endurancerc/32_Servo_Controller/README.md

# 32_Servo_Controller
Firmware for the Endurance R/C 32 Servo Controller
