endurancerc/32_Servo_Controller/FIRMWARE/settings.jpg

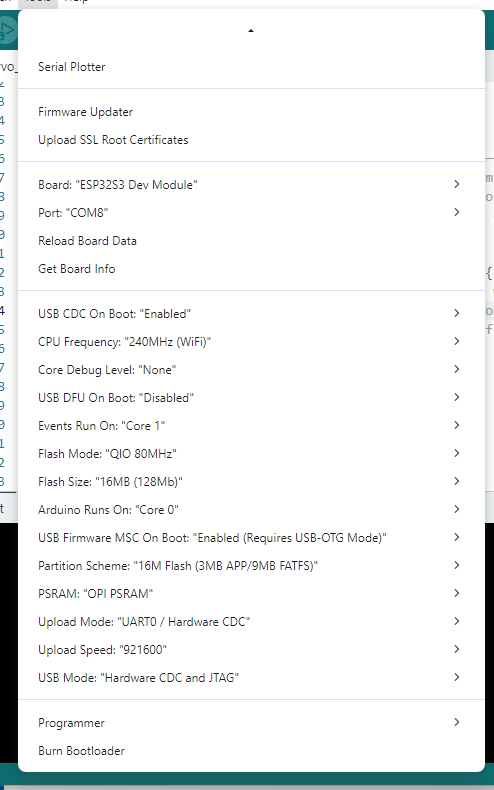
FIRMWARE/settings.jpg
