endurancerc/32_Servo_Controller/PCB/32_Servo_Controller_Schematic.pdf

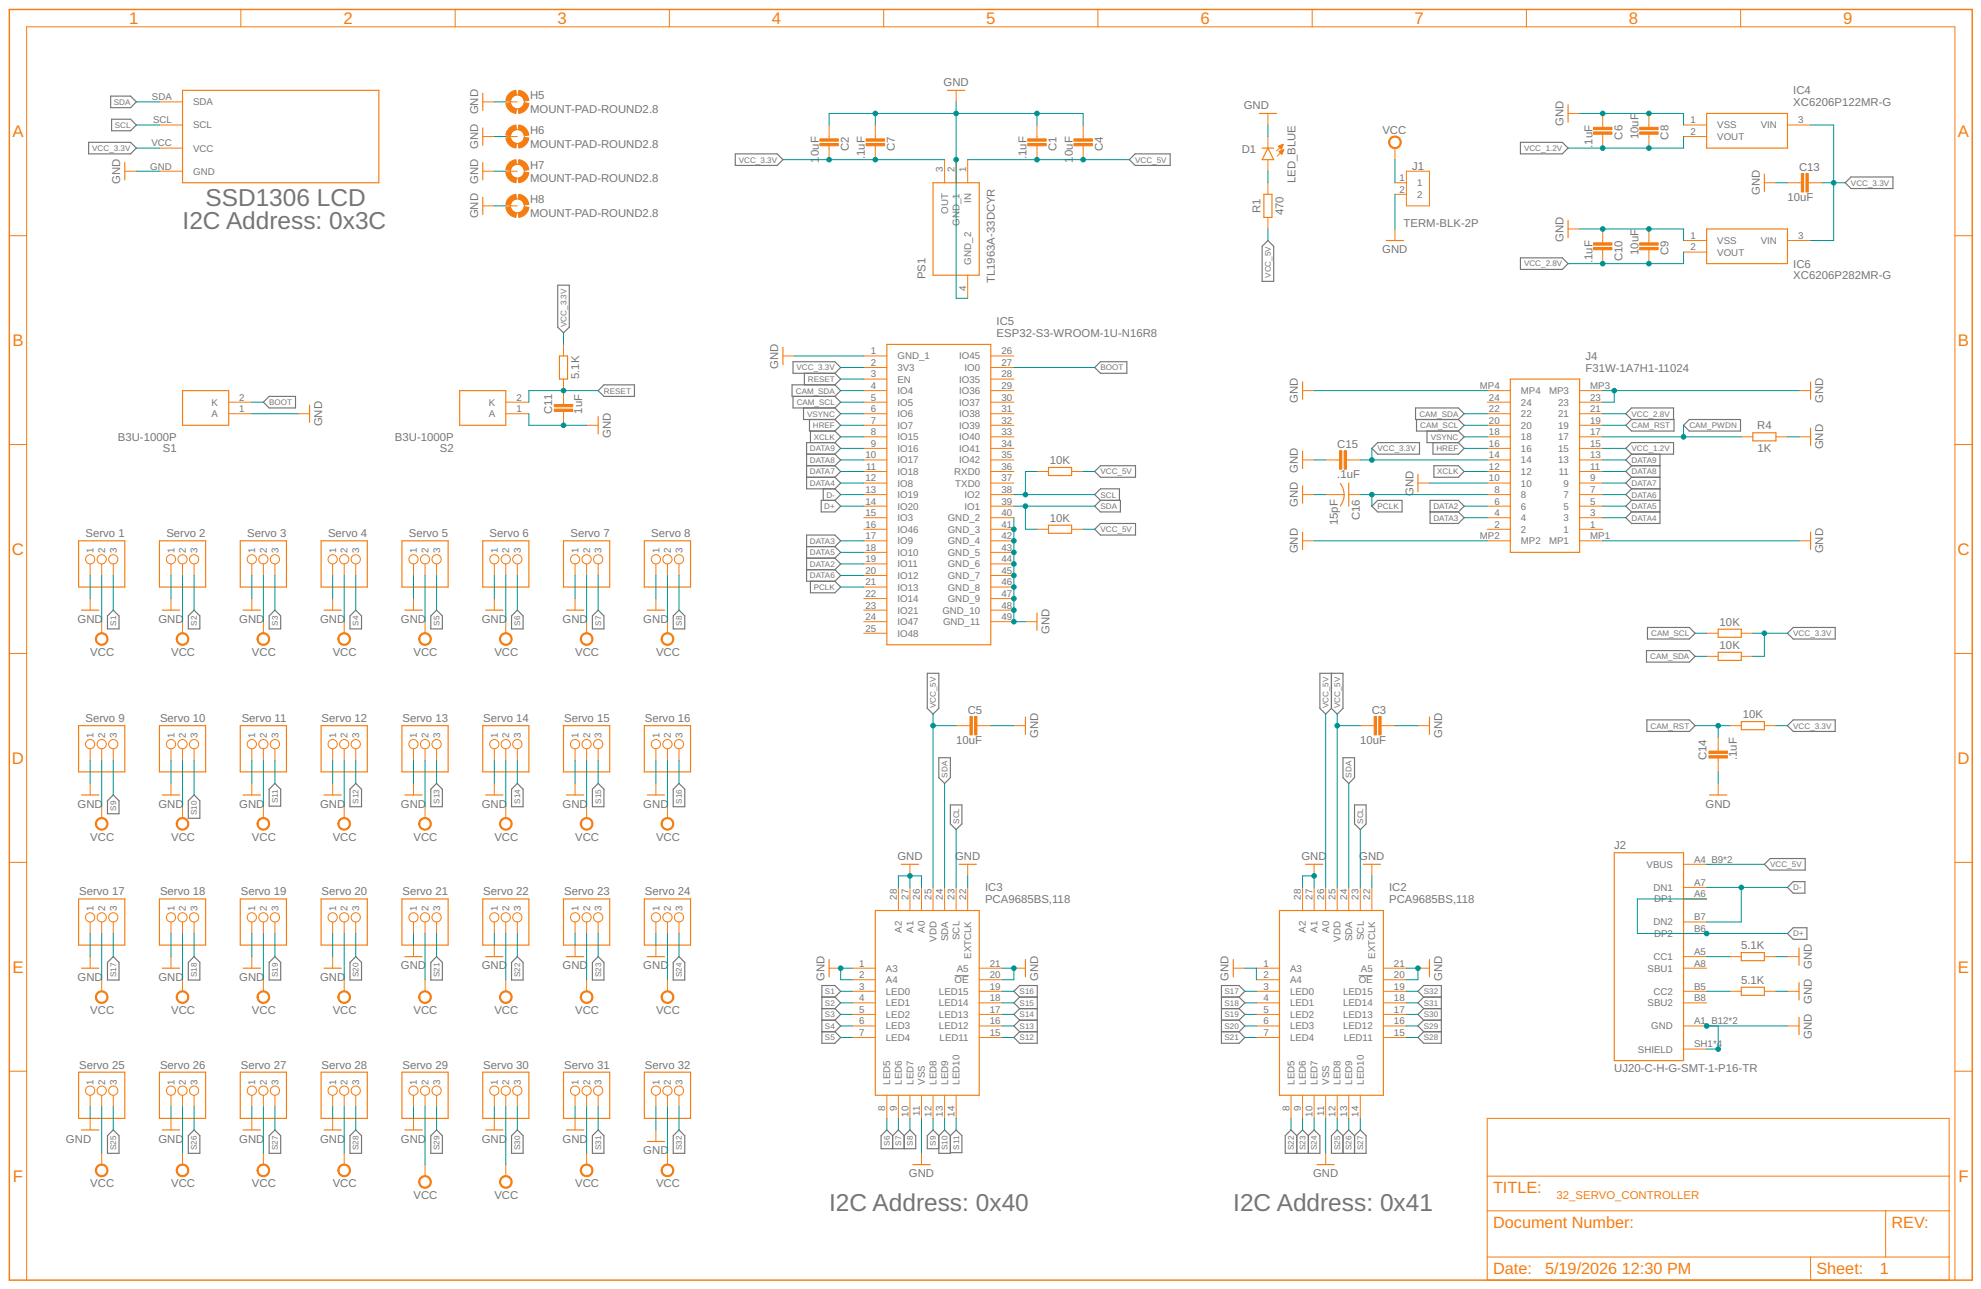
[picture p6: page 1]

GND GND

Document Number: | REV:

Date: 5/19/2026 12:30 PM | Sheet: 1
