endurancerc/32_Servo_Controller/PCB/esp32_servo_lcd_cam.brd

## EAGLE design PCB/esp32_servo_lcd_cam.brd (2026-05-15)

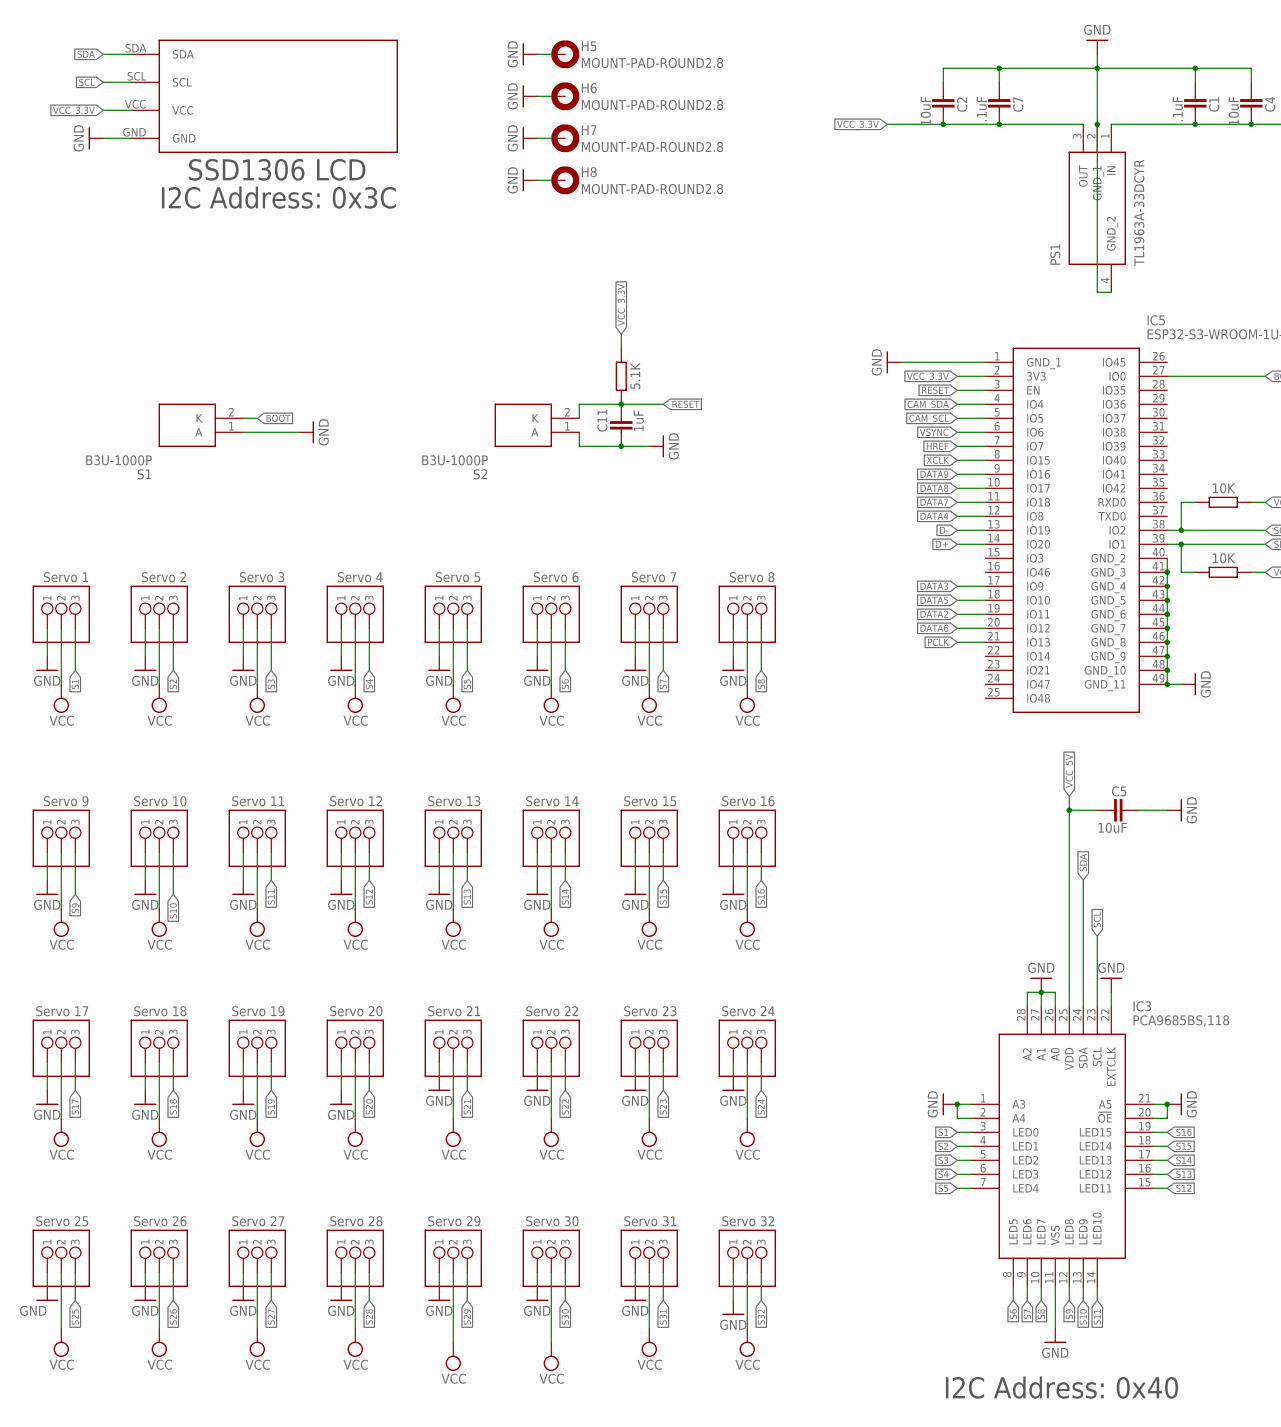
[picture p7: schematic esp32_servo_lcd_cam.sch, part in row 1, column 1]

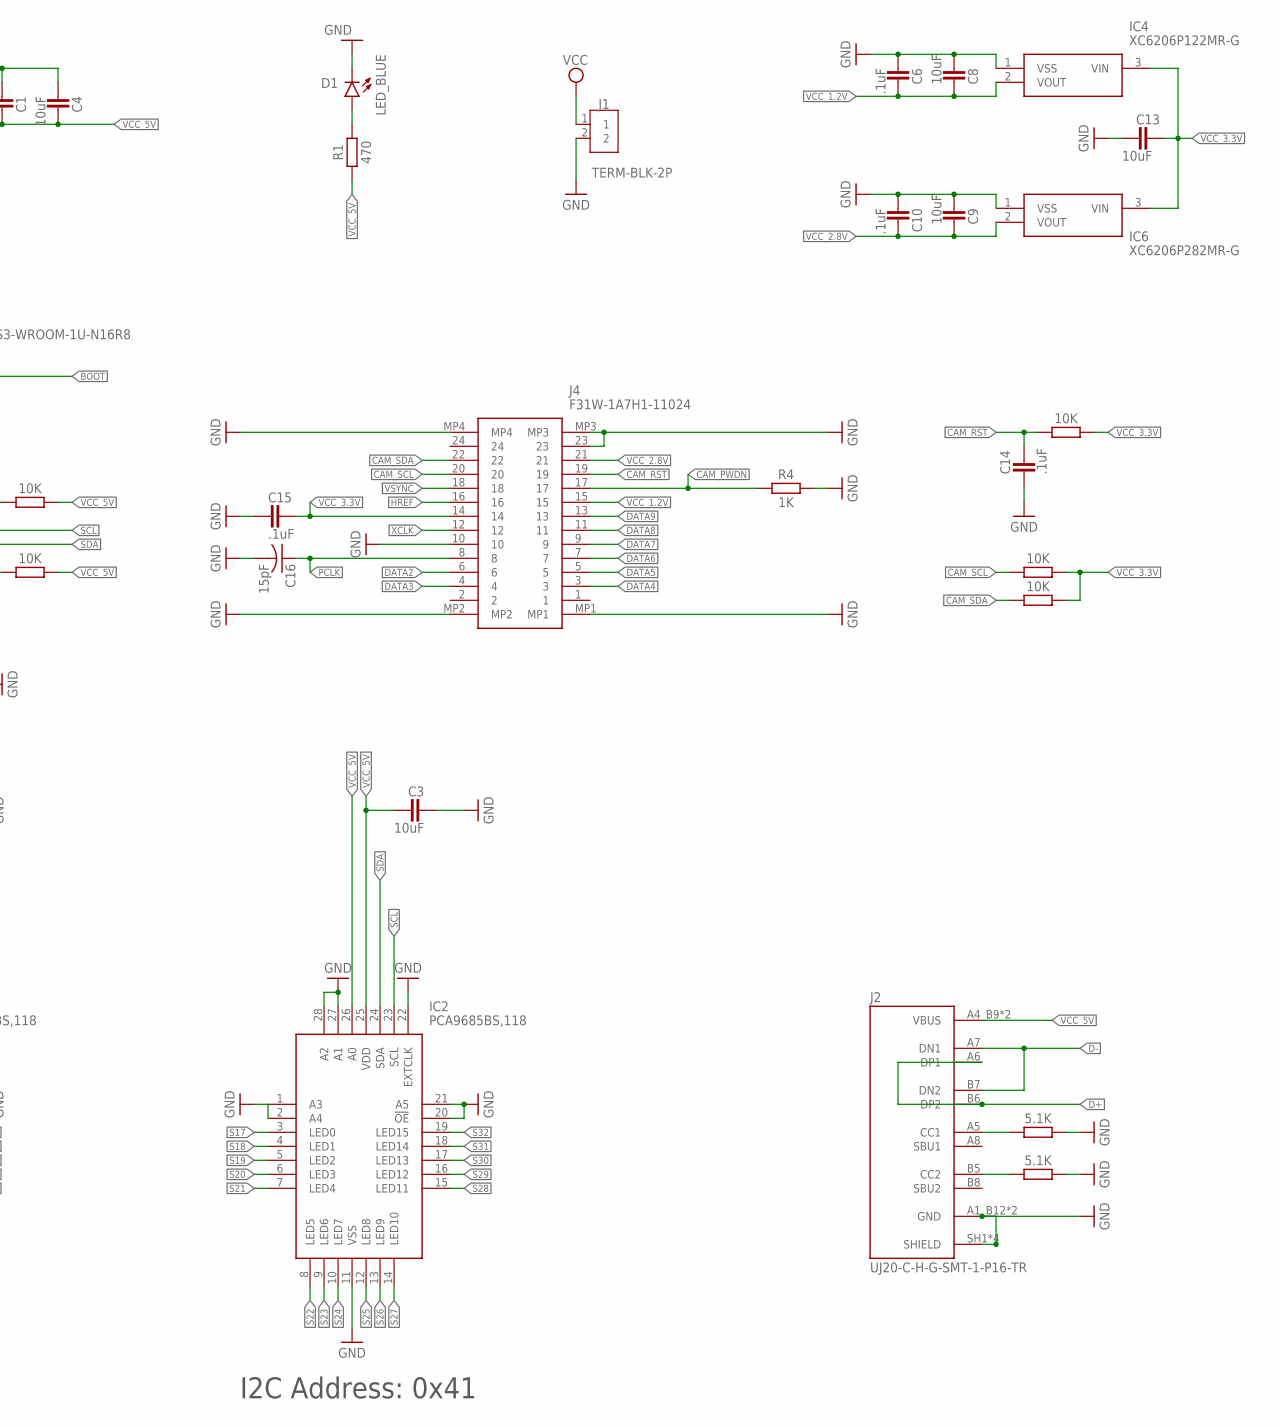
[picture p8: schematic esp32_servo_lcd_cam.sch, part in row 1, column 2]

Parts:
C1, C6, C7, C10, C14, C15: .1uF; CAPC1110X102
C2, C3, C4, C5, C8, C9, C13: 10uF; CAPC1110X102
C11: 1uF; CAPC1110X102
C16: 15pF; CAPC2012X110
D1: LED_BLUE; LEDC1608X80N_FLAT-B
H5, H6, H7, H8: MOUNT-PAD-ROUND2.8; 2,8-PAD
IC2, IC3: PCA9685BS,118; QFN65P600X600X100-29N
IC4: XC6206P122MR-G; SOT95P280X130-3N
IC5: ESP32-S3-WROOM-1U-N16R8; ESP32S3WROOM1UN16R8
IC6: XC6206P282MR-G; SOT95P280X130-3N
J1: TERM-BLK-2P; TERMBLK_508-2N
J2: UJ20-C-H-G-SMT-1-P16-TR; SAMESKY_UJ20-C-H-G-SMT-1-P16-TR
J4: F31W-1A7H1-11024; F31W1A7H111024
PS1: TL1963A-33DCYR; SOT230P700X180-4N
R1: 470; RESC1005X40
R2, R11, R12: 5.1K; RESC1005X40
R3, R5, R6, R23, R24: 10K; RESC1005X40
R4: 1K; RESC1608X60
S1, S2: B3U-1000P
U$1: Servo 6; 1X03
U$2: Servo 7; 1X03
U$3: Servo 8; 1X03
U$4: Servo 9; 1X03
U$5: Servo 10; 1X03
U$6: Servo 11; 1X03
U$7: Servo 12; 1X03
U$8: Servo 13; 1X03
U$9: Servo 14; 1X03
U$10: Servo 15; 1X03
U$11: Servo 4; 1X03
U$12: Servo 5; 1X03
U$13: Servo 1; 1X03
U$14: Servo 3; 1X03
U$15: Servo 2; 1X03
U$16: Servo 16; 1X03
U$17: Servo 17; 1X03
U$18: Servo 18; 1X03
U$19: Servo 19; 1X03
U$20: Servo 21; 1X03
U$21: Servo 20; 1X03
U$22: Servo 22; 1X03
U$23: Servo 23; 1X03
U$24: Servo 24; 1X03
U$25: Servo 25; 1X03
U$26: Servo 26; 1X03
U$27: Servo 27; 1X03
U$28: Servo 28; 1X03
U$29: Servo 29; 1X03
U$30: Servo 30; 1X03
U$31: Servo 31; 1X03
U$32: Servo 32; 1X03
U$33: 128X32_SSD1306_I2C_LCD; 128X32_SSD1306_I2C_LCD_

Connections:
BOOT: IC5.27 (IO0), S1.2 (K)
CAM_PWDN: J4.17, R4.1
CAM_RST: C14.1, J4.19, R3.1
CAM_SCL: IC5.5 (IO5), J4.20, R5.1
CAM_SDA: IC5.4 (IO4), J4.22, R6.1
D+: IC5.14 (IO20), J2.A6 (DP1), J2.B6 (DP2)
D-: IC5.13 (IO19), J2.A7 (DN1), J2.B7 (DN2)
DATA2: IC5.19 (IO11), J4.6
DATA3: IC5.17 (IO9), J4.4
DATA4: IC5.12 (IO8), J4.3
DATA5: IC5.18 (IO10), J4.5
DATA6: IC5.20 (IO12), J4.7
DATA7: IC5.11 (IO18), J4.9
DATA8: IC5.10 (IO17), J4.11
DATA9: IC5.9 (IO16), J4.13
GND: C1.2, C2.2, C3.1, C4.2, C5.1, C6.2, C7.2, C8.2, C9.2, C10.2, C11.2, C13.2, C14.2, C15.2, C16.2, D1.C, H5.B2,8, H6.B2,8, H7.B2,8, H8.B2,8, IC2.11 (VSS), IC2.20 (!OE), IC2.21 (A5), IC2.27 (A1), IC2.28 (A2), IC3.1 (A3), IC3.2 (A4), IC3.11 (VSS), IC3.20 (!OE), IC3.21 (A5), IC3.22 (EXTCLK), IC3.26 (A0), IC3.27 (A1), IC3.28 (A2), IC4.1 (VSS), IC5.1 (GND_1), IC5.40 (GND_2), IC5.41 (GND_3), IC5.42 (GND_4), IC5.43 (GND_5), IC5.44 (GND_6), IC5.45 (GND_7), IC5.46 (GND_8), IC5.47 (GND_9), IC5.48 (GND_10), IC5.49 (GND_11), IC6.1 (VSS), J1.2, J2.A1_B12 (GND), J2.B1_A12 (GND), J2.SH1 (SHIELD), J2.SH2 (SHIELD), J2.SH3 (SHIELD), J2.SH4 (SHIELD), J4.10, J4.23, J4.MP1, J4.MP2, J4.MP3, J4.MP4, PS1.2 (GND_1), PS1.4 (GND_2), R4.2, R11.2, R12.2, S1.1 (A), S2.1 (A), U$1.1, U$2.1, U$3.1, U$4.1, U$5.1, U$6.1, U$7.1, U$8.1, U$9.1, U$10.1, U$11.1, U$12.1, U$13.1, U$14.1, U$15.1, U$16.1, U$17.1, U$18.1, U$19.1, U$20.1, U$21.1, U$22.1, U$23.1, U$24.1, U$25.1, U$26.1, U$27.1, U$28.1, U$29.1, U$30.1, U$31.1, U$32.1, U$33.GND
HREF: IC5.7 (IO7), J4.16
unnamed: D1.A, R1.2
unnamed: J2.A5 (CC1), R12.1
unnamed: J2.B5 (CC2), R11.1
PCLK: C16.1, IC5.21 (IO13), J4.8
RESET: C11.1, IC5.3 (EN), R2.2, S2.2 (K)
S1: IC3.3 (LED0), U$13.3
S2: IC3.4 (LED1), U$15.3
S3: IC3.5 (LED2), U$14.3
S4: IC3.6 (LED3), U$11.3
S5: IC3.7 (LED4), U$12.3
S6: IC3.8 (LED5), U$1.3
S7: IC3.9 (LED6), U$2.3
S8: IC3.10 (LED7), U$3.3
S9: IC3.12 (LED8), U$4.3
S10: IC3.13 (LED9), U$5.3
S11: IC3.14 (LED10), U$6.3
S12: IC3.15 (LED11), U$7.3
S13: IC3.16 (LED12), U$8.3
S14: IC3.17 (LED13), U$9.3
S15: IC3.18 (LED14), U$10.3
S16: IC3.19 (LED15), U$16.3
S17: IC2.3 (LED0), U$17.3
S18: IC2.4 (LED1), U$18.3
S19: IC2.5 (LED2), U$19.3
S20: IC2.6 (LED3), U$21.3
S21: IC2.7 (LED4), U$20.3
S22: IC2.8 (LED5), U$22.3
S23: IC2.9 (LED6), U$23.3
S24: IC2.10 (LED7), U$24.3
S25: IC2.12 (LED8), U$25.3
S26: IC2.13 (LED9), U$26.3
S27: IC2.14 (LED10), U$27.3
S28: IC2.15 (LED11), U$28.3
S29: IC2.16 (LED12), U$29.3
S30: IC2.17 (LED13), U$30.3
S31: IC2.18 (LED14), U$31.3
S32: IC2.19 (LED15), U$32.3
SCL: IC2.23 (SCL), IC3.23 (SCL), IC5.38 (IO2), R23.1, U$33.SCL
SDA: IC2.24 (SDA), IC3.24 (SDA), IC5.39 (IO1), R24.1, U$33.SDA
VCC: J1.1, U$1.2, U$2.2, U$3.2, U$4.2, U$5.2, U$6.2, U$7.2, U$8.2, U$9.2, U$10.2, U$11.2, U$12.2, U$13.2, U$14.2, U$15.2, U$16.2, U$17.2, U$18.2, U$19.2, U$20.2, U$21.2, U$22.2, U$23.2, U$24.2, U$25.2, U$26.2, U$27.2, U$28.2, U$29.2, U$30.2, U$31.2, U$32.2
VCC_1.2V: C6.1, C8.1, IC4.2 (VOUT), J4.15
VCC_2.8V: C9.1, C10.1, IC6.2 (VOUT), J4.21
VCC_3.3V: C2.1, C7.1, C13.1, C15.1, IC4.3 (VIN), IC5.2 (3V3), IC6.3 (VIN), J4.14, PS1.3 (OUT), R2.1, R3.2, R5.2, R6.2, U$33.VCC
VCC_5V: C1.1, C3.2, C4.1, C5.2, IC2.25 (VDD), IC2.26 (A0), IC3.25 (VDD), J2.A4_B9 (VBUS), J2.B4_A9 (VBUS), PS1.1 (IN), R1.1, R23.2, R24.2
VSYNC: IC5.6 (IO6), J4.18
XCLK: IC5.8 (IO15), J4.12

Notes on the sheet:
SSD1306 LCD
I2C Address: 0x40
I2C Address: 0x3C
I2C Address: 0x41

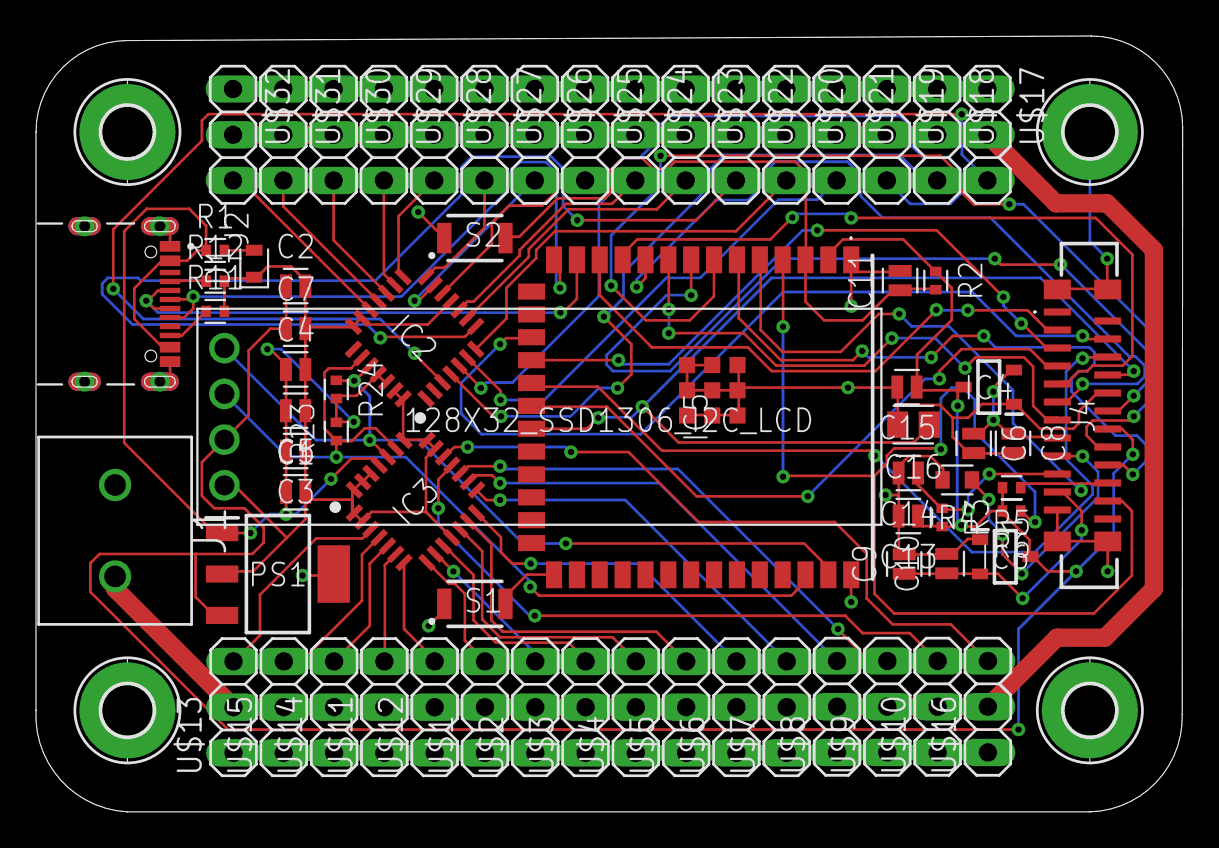
[picture p9: board esp32_servo_lcd_cam.brd from above]

Board: 2 copper layers, 63.7 x 43.1 mm, 74 parts (0 on the bottom side), 63 nets.
