endurancerc/32_Servo_Controller/FIRMWARE/32_Servo_Controller_Camera.ino

// ─────────────────────────────────────────────────────────────
//  32 Servo Controller — Combined USB HID + WiFi + Camera
//  Boots into USB HID mode if USB host detected, WiFi otherwise
//  WiFi mode: OV2640 MJPEG stream on port 81, servo control on port 80
//  Host fingerprinting detects Android vs Windows via HID timing delta
// ─────────────────────────────────────────────────────────────

// These defines burn the correct strings into the compiled USB descriptor,
// so Chrome's device picker shows the right name before setup() even runs.
#define USB_PRODUCT      "32 Servo Controller"
#define USB_MANUFACTURER "Endurance R/C"

#include "esp_camera.h"
#include <WiFi.h>
#include <WebServer.h>
#include <Preferences.h>
#include <DNSServer.h>
#include <ESPmDNS.h>
#include <Wire.h>
#include <Adafruit_PWMServoDriver.h>
#include <Adafruit_GFX.h>
#include <Adafruit_SSD1306.h>
#include "USB.h"
#include "USBHID.h"
#include "USBCDC.h"
#include "esp_system.h"        // esp_reset_reason()
#include "esp_task_wdt.h"      // esp_task_wdt_delete()
#include "soc/soc.h"           // WRITE_PERI_REG
#include "soc/rtc_cntl_reg.h"  // RTC_CNTL_BROWN_OUT_REG

USBCDC FPSerial;

// ─────────────────────────────────────────────────────────────
//  Common hardware defines
// ─────────────────────────────────────────────────────────────
#define I2C_SDA 1
#define I2C_SCL 2
#define NUM_SERVOS 32
#define SERVO_FREQ 50
#define USMIN 600
#define USMAX 2400
#define US_SCALE 7.06f

#define SCREEN_WIDTH 128
#define SCREEN_HEIGHT 32
#define OLED_RESET -1
#define SCREEN_ADDRESS 0x3C

// ─────────────────────────────────────────────────────────────
//  OV2640 Camera pin map
// ─────────────────────────────────────────────────────────────
#define PWDN_GPIO_NUM   -1   // not wired
#define RESET_GPIO_NUM  -1
#define XCLK_GPIO_NUM   15
#define SIOD_GPIO_NUM    4   // camera SCCB SDA (separate bus from servo I2C)
#define SIOC_GPIO_NUM    5   // camera SCCB SCL
#define Y2_GPIO_NUM     11
#define Y3_GPIO_NUM      9
#define Y4_GPIO_NUM      8
#define Y5_GPIO_NUM     10
#define Y6_GPIO_NUM     12
#define Y7_GPIO_NUM     18
#define Y8_GPIO_NUM     17
#define Y9_GPIO_NUM     16
#define VSYNC_GPIO_NUM   6
#define HREF_GPIO_NUM    7
#define PCLK_GPIO_NUM   13
// If camera init returns error 0x105, try: #define XCLK_GPIO_NUM 40

// ─────────────────────────────────────────────────────────────
//  Mode flag — set once in setup() before USB or WiFi inits
// ─────────────────────────────────────────────────────────────
bool usbMode = false;

// ─────────────────────────────────────────────────────────────
//  I2C hardware objects
// ─────────────────────────────────────────────────────────────
Adafruit_SSD1306 display(SCREEN_WIDTH, SCREEN_HEIGHT, &Wire, OLED_RESET);
Adafruit_PWMServoDriver pwmA = Adafruit_PWMServoDriver(0x40);
Adafruit_PWMServoDriver pwmB = Adafruit_PWMServoDriver(0x41);

// ─────────────────────────────────────────────────────────────
//  USB HID — objects / state (only activated if usbMode == true)
// ─────────────────────────────────────────────────────────────
USBHID HID;

static const uint8_t customReportDescriptor[] = {
  0x06, 0xA0, 0xFF,
  0x09, 0x01,
  0xA1, 0x01,
  0x09, 0x03,
  0x15, 0x00,
  0x26, 0x00, 0xFF,
  0x75, 0x08,
  0x95, 0x20,
  0x81, 0x02,
  0x09, 0x04,
  0x15, 0x00,
  0x26, 0x00, 0xFF,
  0x75, 0x08,
  0x95, 0x20,
  0x91, 0x02,
  0x09, 0x05,
  0x15, 0x00,
  0x26, 0x00, 0xFF,
  0x75, 0x08,
  0x95, 0x20,
  0xB1, 0x02,
  0xC0
};

struct ServoReport {
  uint8_t servoPosition[32];
};

volatile uint8_t servoBuffer[2][32] = { { 0 }, { 0 } };
volatile uint8_t writeBuffer = 0;
volatile uint8_t readBuffer = 1;
volatile bool bufferReady = false;
volatile bool usbWasConnected = false;
volatile unsigned long lastUSBActivity = 0;
static unsigned long lastPrint = 0;

// ── Cross-core synchronisation ────────────────────────────────
// portMUX_TYPE is safe to use from both a FreeRTOS task and an ISR
// on either core; noInterrupts() only masks Core 1 and is NOT
// sufficient when the USB stack runs concurrently on Core 0.
static portMUX_TYPE bufferMux = portMUX_INITIALIZER_UNLOCKED;
static SemaphoreHandle_t usbSendMutex = nullptr;  // created in setup()

// ─────────────────────────────────────────────────────────────
//  USB Host Fingerprinting
//
//  Signals collected during the enumeration handshake and scored
//  to produce a best-guess HostType.  All volatile globals below
//  are written from USB ISR context (Core 0) and read from loop()
//  (Core 1); they are simple scalars so word-torn reads are safe
//  on Xtensa without additional locking.
// ─────────────────────────────────────────────────────────────
enum HostType : uint8_t {
  HOST_UNKNOWN = 0,
  HOST_ANDROID,
  HOST_WINDOWS,
  HOST_LINUX,
  HOST_MACOS
};

static const char* hostTypeName(HostType t) {
  switch (t) {
    case HOST_ANDROID: return "ANDROID";
    case HOST_WINDOWS: return "WINDOWS";
    case HOST_LINUX: return "LINUX";
    case HOST_MACOS: return "MACOS";
    default: return "UNKNOWN";
  }
}

// ── Fingerprint signals ───────────────────────────────────────
// Primary discriminator: Windows reads the BOS descriptor, finds the
// MS OS 2.0 Platform Capability entry the library always includes, and
// sends a vendor request (bRequest=2 / VENDOR_REQUEST_MICROSOFT, wIndex=7).
// Android never requests BOS for HID devices so this never fires on Android.
// tinyusb_vendor_control_request_cb() below catches it — it is declared
// __attribute__((weak)) in esp32-hal-tinyusb.c so no library edit is needed.

static volatile bool fp_eeStringRequested = false;    // Windows-only: string 0xEE probe
static volatile bool fp_msVendorReqReceived = false;  // secondary (USB 2.1 only, unused at 2.0)
static volatile bool fp_setIdleReceived = false;
static volatile bool fp_setProtocolReceived = false;
static volatile uint8_t fp_setProtocolValue = 0xFF;
static volatile bool fp_getReportReceived = false;
static volatile bool fp_getIdleReceived = false;
static volatile bool fp_getProtocolReceived = false;
// Timestamps: fp_connectTimeMs set in setup() right after while(!USB).
static volatile unsigned long fp_connectTimeMs = 0;
static volatile unsigned long fp_firstHIDReqMs = 0;
static volatile unsigned long fp_setIdleMs = 0;
static volatile unsigned long fp_setProtocolMs = 0;
static volatile unsigned long fp_getReportMs = 0;
// Evaluated result
static volatile bool fp_evaluated = false;
HostType detectedHostType = HOST_UNKNOWN;

#define FP_TIMING_THRESHOLD_MS 8   // Android ~0-2 ms, Windows ~15-25 ms — threshold splits them cleanly

// ── Scorer (no I/O — safe to call from any context) ──────────
// Returns the host type based purely on timing.  Does NOT write to
// FPSerial so it cannot block loop() regardless of CDC state.
static HostType scoreHostType() {
  unsigned long delta = (fp_firstHIDReqMs >= fp_connectTimeMs)
                          ? (fp_firstHIDReqMs - fp_connectTimeMs)
                          : 0UL;
  return (delta >= FP_TIMING_THRESHOLD_MS) ? HOST_WINDOWS : HOST_ANDROID;
}

// ── Report printer — only call when host is confirmed Windows ─
// All FPSerial output lives here so Android never sees a write attempt.
static void printFingerprintReport(HostType result) {
  unsigned long hidDelta = (fp_firstHIDReqMs >= fp_connectTimeMs)
                             ? (fp_firstHIDReqMs - fp_connectTimeMs)
                             : 0UL;
  FPSerial.println("[FP] ════ FINGERPRINT REPORT ════");
  FPSerial.printf("[FP] fp_connectTimeMs      : %lu\n", (unsigned long)fp_connectTimeMs);
  FPSerial.printf("[FP] fp_firstHIDReqMs      : %lu  (delta +%lu ms)\n",
                  (unsigned long)fp_firstHIDReqMs, hidDelta);
  FPSerial.printf("[FP] HID req delta (key)    : %lu ms  (threshold %d ms)\n",
                  hidDelta, FP_TIMING_THRESHOLD_MS);
  FPSerial.printf("[FP] SET_IDLE received      : %s", fp_setIdleReceived ? "YES" : "NO");
  if (fp_setIdleReceived && fp_setIdleMs >= fp_connectTimeMs)
    FPSerial.printf("  (+%lu ms)\n", (unsigned long)(fp_setIdleMs - fp_connectTimeMs));
  else FPSerial.println();
  FPSerial.printf("[FP] SET_PROTOCOL recv      : %s  val=%d",
                  fp_setProtocolReceived ? "YES" : "NO", fp_setProtocolValue);
  if (fp_setProtocolReceived && fp_setProtocolMs >= fp_connectTimeMs)
    FPSerial.printf("  (+%lu ms)\n", (unsigned long)(fp_setProtocolMs - fp_connectTimeMs));
  else FPSerial.println();
  FPSerial.printf("[FP] GET_REPORT recv        : %s", fp_getReportReceived ? "YES" : "NO");
  if (fp_getReportReceived && fp_getReportMs >= fp_connectTimeMs)
    FPSerial.printf("  (+%lu ms)\n", (unsigned long)(fp_getReportMs - fp_connectTimeMs));
  else FPSerial.println();
  FPSerial.printf("[FP] GET_IDLE received      : %s\n", fp_getIdleReceived ? "YES" : "NO");
  FPSerial.printf("[FP] GET_PROTOCOL recv      : %s\n", fp_getProtocolReceived ? "YES" : "NO");
  FPSerial.println("[FP] ════════════════════════════");
  if (result == HOST_WINDOWS)
    FPSerial.printf("[FP] RESULT: WINDOWS (HID delta %lu ms >= %d ms threshold)\n",
                    hidDelta, FP_TIMING_THRESHOLD_MS);
  else
    FPSerial.printf("[FP] RESULT: ANDROID / non-Windows (HID delta %lu ms < %d ms threshold)\n",
                    hidDelta, FP_TIMING_THRESHOLD_MS);
}

// ── Fingerprint reset ────────────────────────────────────────
static void fp_reset() {
  fp_eeStringRequested = false;
  fp_msVendorReqReceived = false;
  fp_setIdleReceived = false;
  fp_setProtocolReceived = false;
  fp_setProtocolValue = 0xFF;
  fp_getReportReceived = false;
  fp_getIdleReceived = false;
  fp_getProtocolReceived = false;
  fp_firstHIDReqMs = 0;
  fp_setIdleMs = 0;
  fp_setProtocolMs = 0;
  fp_getReportMs = 0;
  fp_evaluated = false;
  detectedHostType = HOST_UNKNOWN;
  // fp_connectTimeMs is set separately in setup()
}

class CustomHID : public USBHIDDevice {
private:
  ServoReport lastReport = { 0 };
public:
  CustomHID(void) {
    static bool initialized = false;
    if (!initialized) {
      initialized = true;
      HID.addDevice(this, sizeof(customReportDescriptor));
    }
  }
  void begin(void) {
    HID.begin();
  }
  uint16_t _onGetDescriptor(uint8_t* buffer) {
    memcpy(buffer, customReportDescriptor, sizeof(customReportDescriptor));
    return sizeof(customReportDescriptor);
  }
  bool sendReport(ServoReport* report) {
    if (!usbSendMutex) return false;
    bool ok = false;
    if (xSemaphoreTake(usbSendMutex, pdMS_TO_TICKS(5)) == pdTRUE) {
      ok = HID.SendReport(1, report, sizeof(ServoReport));
      xSemaphoreGive(usbSendMutex);
    }
    return ok;
  }
  void _onOutput(uint8_t report_id, const uint8_t* buffer, uint16_t len) {
    lastUSBActivity = millis();
    if (len >= 32) {
      taskENTER_CRITICAL(&bufferMux);
      uint8_t wb = writeBuffer;
      for (int i = 0; i < 32; i++) servoBuffer[wb][i] = buffer[i];
      bufferReady = true;
      taskEXIT_CRITICAL(&bufferMux);
    }
  }
  uint16_t _onGetReport(uint8_t report_id, uint8_t* buffer, uint16_t len) {
    unsigned long now = millis();
    lastUSBActivity = now;
    if (fp_firstHIDReqMs == 0) fp_firstHIDReqMs = now;
    fp_getReportReceived = true;
    fp_getReportMs = now;
    // No FPSerial here — Core-0 USB callback; CDC writes cause WDT resets.
    if (len >= 32) {
      memcpy(buffer, &lastReport, 32);
      return 32;
    }
    return 0;
  }
  void _onSetReport(uint8_t report_id, const uint8_t* buffer, uint16_t len) {
    lastUSBActivity = millis();
    if (len >= 32) {
      taskENTER_CRITICAL(&bufferMux);
      uint8_t wb = writeBuffer;
      for (int i = 0; i < 32; i++) servoBuffer[wb][i] = buffer[i];
      bufferReady = true;
      taskEXIT_CRITICAL(&bufferMux);
    }
  }
  // ── Fingerprinting hook ──────────────────────────────────────
  // _onSetup is called by the ESP32 Arduino USBHID layer for every
  // HID class-type setup packet BEFORE TinyUSB's default handler.
  // We peek at the request, record it, then return false so TinyUSB
  // handles the ACK/response normally — we never disrupt USB traffic.
  //
  // setup[] layout (8 bytes, USB spec §9.3):
  //   [0] bmRequestType  [1] bRequest
  //   [2] wValue-lo      [3] wValue-hi
  //   [4] wIndex-lo      [5] wIndex-hi
  //   [6] wLength-lo     [7] wLength-hi
  bool _onSetup(const uint8_t setup[8], uint8_t* buf, uint16_t* len) {
    unsigned long now = millis();
    if (fp_firstHIDReqMs == 0) fp_firstHIDReqMs = now;
    long delta = (fp_connectTimeMs > 0) ? (long)(now - fp_connectTimeMs) : -1;

    uint8_t bmRT = setup[0];
    uint8_t bRequest = setup[1];
    uint8_t wValLo = setup[2];
    uint8_t wValHi = setup[3];

    // Record signals only — no FPSerial calls here.
    // _onSetup runs on the Core-0 USB task; CDC writes from this context
    // can deadlock the USB stack and trigger the Core-0 WDT.
    // scoreHostType() in loop() evaluates after the window closes; printFingerprintReport() only fires on Windows.
    switch (bRequest) {
      case 0x0A:
        fp_setIdleReceived = true;
        fp_setIdleMs = now;
        break;  // SET_IDLE
      case 0x0B:
        fp_setProtocolReceived = true;  // SET_PROTOCOL
        fp_setProtocolValue = wValLo;
        fp_setProtocolMs = now;
        break;
      case 0x02: fp_getIdleReceived = true; break;      // GET_IDLE
      case 0x03: fp_getProtocolReceived = true; break;  // GET_PROTOCOL
      default: break;
    }

    return false;  // always defer to TinyUSB default handler
  }

  void updateLastReport(uint8_t* data) {
    memcpy(lastReport.servoPosition, data, 32);
  }
  void sendKeepalive() {
    if (!USB) return;  // don't send if host isn't connected
    if (!usbSendMutex) return;
    if (xSemaphoreTake(usbSendMutex, pdMS_TO_TICKS(5)) == pdTRUE) {
      HID.SendReport(1, &lastReport, sizeof(ServoReport));
      xSemaphoreGive(usbSendMutex);
    }
  }
};

CustomHID controller;

// ─────────────────────────────────────────────────────────────
//  USB descriptor strings — set via a global constructor so they
//  are applied before Arduino's initArduino() starts the USB stack,
//  which happens before setup() is ever called.  Calling
//  USB.productName() inside setup() is too late.
// ─────────────────────────────────────────────────────────────
static const struct _USBEarlyInit {
  _USBEarlyInit() {
    USB.VID(0x0925);
    USB.PID(0x1299);
    USB.productName("32 Servo Controller");
    USB.manufacturerName("Endurance R/C");
    USB.serialNumber("32SC001");
  }
} _usbEarlyInit;


// ─────────────────────────────────────────────────────────────
//  TinyUSB weak callbacks — fingerprinting backup layer
//
//  TinyUSB declares tud_hid_set_idle_cb and tud_hid_set_protocol_cb
//  as TU_ATTR_WEAK symbols.  Defining them here overrides the empty
//  stubs so we are guaranteed to see SET_IDLE / SET_PROTOCOL even if
//  the Arduino USBHID wrapper version running on the target handles
//  those requests before forwarding them to _onSetup.
//
//  These run in the USB task / ISR context (Core 0).  Only plain
//  volatile writes and Serial prints are safe here.
// ─────────────────────────────────────────────────────────────
// ESP32 Arduino 2.0.x TinyUSB signature: bool(instance, idle_rate) — no report_id.
// Return true to ACK; TinyUSB sends the ZLP status stage for us.
extern "C" bool tud_hid_set_idle_cb(uint8_t instance, uint8_t idle_rate) {
  unsigned long now = millis();
  if (fp_firstHIDReqMs == 0) fp_firstHIDReqMs = now;
  fp_setIdleReceived = true;
  if (fp_setIdleMs == 0) fp_setIdleMs = now;
  // No FPSerial call — runs on Core-0 USB task; CDC writes here cause WDT resets.
  return true;
}

extern "C" void tud_hid_set_protocol_cb(uint8_t instance, uint8_t protocol) {
  if (fp_firstHIDReqMs == 0) fp_firstHIDReqMs = millis();
  fp_setProtocolReceived = true;
  fp_setProtocolValue = protocol;
  // No FPSerial call — same reason as above.
}

// ─────────────────────────────────────────────────────────────
//  Host discriminator — timing-based
//
//  All passive USB signal approaches (string 0xEE, BOS/MS OS 2.0) either
//  require USB 2.1 which causes Android to reset the bus repeatedly, or
//  are cached by Windows and stop firing after the first plug-in.
//
//  The reliable discriminator that requires no library hacks and causes
//  no enumeration side-effects is the timing gap between USB connect and
//  the first HID class request:
//
//    Windows:  ~15–25 ms  — Windows must load/match the HID driver first,
//                           then the driver sends SET_IDLE.
//    Android:  ~0–2 ms   — Android's built-in kernel HID stack sends
//                           SET_IDLE as part of enumeration itself.
//
//  Threshold: 8 ms.  Values consistently observed: Windows ~20 ms,
//  Android ~0 ms.  If the gap ever turns out to overlap on real hardware
//  the threshold can be tuned here.
// ─────────────────────────────────────────────────────────────

// ─────────────────────────────────────────────────────────────
//  WiFi — objects / state (only activated if usbMode == false)
// ─────────────────────────────────────────────────────────────
volatile int sliderValues[NUM_SERVOS] = { 0 };
SemaphoreHandle_t sliderMutex = nullptr;
TaskHandle_t webTaskHandle = nullptr;
TaskHandle_t hardwareTaskHandle = nullptr;

#define AP_SSID        "32_SC"
#define AP_PASSWORD    "12345678"
#define AP_IP          IPAddress(192, 168, 4, 1)


WebServer   server(80);        // control API — always responsive
WiFiServer  streamServer(81);  // raw MJPEG stream — separate from control API
WiFiClient  streamClient;

DNSServer   dns;
Preferences prefs;

enum Mode { MODE_AP, MODE_STA };
Mode currentMode = MODE_AP;
String savedSsid;
String savedPass;
String savedNetMode;   // "ap" or "sta" — persisted to prefs

// ── Camera reinit signal (web task → hardware task) ──────────
volatile bool         reinitRequested  = false;
volatile framesize_t  pendingFrameSize = FRAMESIZE_XGA;

// ── Camera presence flag (set at boot, false if not wired) ───
bool cameraAvailable = false;

// ── Web-visible syslog ring buffer ───────────────────────────
#define SYSLOG_MAX 48
static String   _syslogBuf[SYSLOG_MAX];
static uint32_t _syslogTotal = 0;

// ── Stream telemetry (updated by hardware task, read by web task) ──
volatile uint16_t streamFps  = 0;   // frames per second
volatile uint32_t streamKbps = 0;   // kilobits per second
// Internal accumulators (hardware task only — no mutex needed)
static uint32_t _fpsFrameCount = 0;
static uint32_t _bpsByteCount  = 0;
static uint32_t _statsLastMs   = 0;

// Forward declarations
bool isConnectedToUSBHost();
void showEnduranceRC_WIFI_MODE();
void showEnduranceRC_USB_MODE();
void displayWiFiSignal();

static const char SETUP_HTML[] PROGMEM = R"rawliteral(
<!DOCTYPE html>
<html lang="en">
<head>
  <meta charset="UTF-8">
  <meta name="viewport" content="width=device-width, initial-scale=1">
<link rel="icon" type="image/x-icon" href="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">
  <title>32 Servo Controller - Setup</title>
  <style>
    *{box-sizing:border-box;margin:0;padding:0}
    :root{--bg:#050709;--accent:#00ffe7;--accent2:#ff3c5f;--text:#b8d8e8;--dim:#3a5060;--danger:#ff3c5f}
    html,body{
      min-height:100vh;background:var(--bg);color:var(--text);
      font-family:'Orbitron',monospace;
      display:flex;flex-direction:column;align-items:center;justify-content:center;padding:20px;gap:20px;
    }
    body::before{
      content:'';position:fixed;inset:0;
      background-image:linear-gradient(rgba(0,255,231,0.05) 1px,transparent 1px),
        linear-gradient(90deg,rgba(0,255,231,0.05) 1px,transparent 1px);
      background-size:48px 48px;pointer-events:none;z-index:0;
    }
    body::after{
      content:'';position:fixed;inset:0;
      background:repeating-linear-gradient(0deg,transparent,transparent 3px,rgba(0,0,0,0.08) 3px,rgba(0,0,0,0.08) 4px);
      pointer-events:none;z-index:0;
    }
    @keyframes statglow-cyan{
      0%,100%{text-shadow:-2px 0 rgba(0,255,231,.45),2px 0 rgba(255,60,95,.45),0 0 10px rgba(0,255,231,.8),0 0 24px rgba(0,255,231,.4)}
      50%{text-shadow:-4px 0 rgba(0,255,231,.7),4px 0 rgba(255,60,95,.7),0 0 22px rgba(0,255,231,1),0 0 44px rgba(0,255,231,.5)}
    }
    @keyframes statglow-pink{
      0%,100%{text-shadow:2px 0 rgba(255,60,95,.45),-2px 0 rgba(0,255,231,.45),0 0 10px rgba(255,60,95,.7),0 0 24px rgba(255,60,95,.3)}
      50%{text-shadow:4px 0 rgba(255,60,95,.7),-4px 0 rgba(0,255,231,.7),0 0 22px rgba(255,60,95,1),0 0 44px rgba(255,60,95,.5)}
    }
    @keyframes logo-flicker{0%,90%,92%,97%,97.5%,100%{opacity:1}91.4%{opacity:.12}97.2%{opacity:.55}}
    @keyframes pulseline{0%,100%{opacity:.9}50%{opacity:.2}}
    @keyframes fadeInUp{from{opacity:0;transform:translateY(12px)}to{opacity:1;transform:none}}
    .logo-wrap{text-align:center;position:relative;z-index:1}
    .logo{font-size:1.2rem;font-weight:800;letter-spacing:4px;text-transform:uppercase}
    .logo-real{color:var(--accent);animation:statglow-cyan 2.5s ease-in-out infinite,logo-flicker 8s ease-in-out infinite}
    .logo-driver{color:var(--accent2);animation:statglow-pink 2.5s ease-in-out infinite,logo-flicker 8s ease-in-out infinite .3s}
    .logo-subtitle{font-family:'Share Tech Mono',monospace;font-size:9px;letter-spacing:3px;color:var(--accent);margin-top:4px}
    .login-box{
      width:340px;max-width:95vw;background:rgba(5,10,16,0.85);
      padding:28px 24px;position:relative;
      animation:fadeInUp .5s .1s ease both;
      backdrop-filter:blur(8px);z-index:1;
    }
    .login-box::before{
      content:'';position:absolute;top:0;left:0;right:0;height:2px;
      background:linear-gradient(90deg,transparent,var(--accent),var(--accent2),var(--accent),transparent);
      animation:pulseline 2s ease-in-out infinite;
    }
    .corner-tl,.corner-tr,.corner-bl,.corner-br{position:absolute;width:12px;height:12px}
    .corner-tl{top:0;left:0;border-top:1.5px solid var(--accent);border-left:1.5px solid var(--accent)}
    .corner-tr{top:0;right:0;border-top:1.5px solid var(--accent);border-right:1.5px solid var(--accent)}
    .corner-bl{bottom:0;left:0;border-bottom:1.5px solid var(--accent2);border-left:1.5px solid var(--accent2)}
    .corner-br{bottom:0;right:0;border-bottom:1.5px solid var(--accent2);border-right:1.5px solid var(--accent2)}
    .field-wrap{margin-bottom:14px}
    .field-label{font-size:.6rem;letter-spacing:3px;color:var(--dim);text-transform:uppercase;margin-bottom:6px;font-family:'Share Tech Mono',monospace}
    input[type=text],input[type=password]{
      width:100%;background:rgba(0,20,30,0.75);
      border:1px solid rgba(0,255,231,0.3);color:var(--accent);
      font-family:'Share Tech Mono',monospace;font-size:.8rem;
      padding:10px 14px;outline:none;transition:border-color .2s,background .2s;
    }
    input[type=text]::placeholder,input[type=password]::placeholder{color:var(--dim);opacity:.7}
    input[type=text]:focus,input[type=password]:focus{border-color:rgba(0,255,231,.85);background:rgba(0,30,45,.82)}
    .pw-wrap{position:relative}
    .pw-wrap input{padding-right:44px}
    .eye{position:absolute;right:12px;top:50%;transform:translateY(-50%);cursor:pointer;color:var(--dim);font-size:1.1rem;user-select:none}
    .scan-row{display:flex;gap:8px;align-items:stretch}
    .ssid-dropdown{position:relative;font-family:'Share Tech Mono',monospace;flex:1;z-index:100}
    .ssid-trigger{
      display:flex;align-items:center;justify-content:space-between;gap:8px;
      background:rgba(0,20,30,0.75);border:1px solid rgba(0,255,231,0.3);color:var(--accent);
      padding:10px 14px;cursor:pointer;font-size:.7rem;font-weight:700;
      letter-spacing:.08em;text-transform:uppercase;white-space:nowrap;user-select:none;width:100%;
      transition:border-color .2s;
    }
    .ssid-trigger:hover{border-color:var(--accent)}
    .ssid-arrow{font-size:.65rem;transition:transform .25s;flex-shrink:0}
    .ssid-dropdown.open .ssid-arrow{transform:rotate(180deg)}
    .ssid-menu{
      display:none;position:absolute;top:calc(100% + 4px);left:0;
      list-style:none;padding:4px 0;margin:0;
      background:#050d14;border:1px solid rgba(0,255,231,0.2);
      min-width:100%;max-height:200px;overflow-y:auto;
      box-shadow:0 0 20px rgba(0,255,231,.12),0 8px 32px #000c;
    }
    .ssid-dropdown.open .ssid-menu{display:block}
    .ssid-menu li{
      display:flex;justify-content:space-between;align-items:center;gap:12px;
      padding:9px 14px;color:var(--text);font-size:.74rem;
      letter-spacing:.06em;text-transform:uppercase;cursor:pointer;
      border-left:2px solid transparent;transition:background .1s,color .1s,border-color .1s;
    }
    .ssid-menu li span{color:var(--dim);font-size:.7rem}
    .ssid-menu li:hover{background:rgba(0,255,231,.06);color:var(--accent);border-left-color:var(--accent)}
    .ssid-placeholder{color:var(--dim)!important;cursor:default!important;font-size:.7rem!important;text-transform:none!important;letter-spacing:.04em!important}
    .ssid-placeholder:hover{background:transparent!important;border-left-color:transparent!important;color:var(--dim)!important}
    .btn-scan{
      background:rgba(0,20,30,0.75);border:1px solid rgba(0,255,231,0.25);color:var(--dim);
      padding:10px 14px;cursor:pointer;font-size:.6rem;font-family:'Orbitron',monospace;
      letter-spacing:2px;text-transform:uppercase;white-space:nowrap;
      transition:border-color .2s,color .2s;flex-shrink:0;
    }
    .btn-scan:hover{border-color:var(--accent);color:var(--accent)}
    .btn-connect{
      margin-top:8px;width:100%;background:rgba(0,20,30,0.75);color:var(--accent);
      border:1px solid rgba(0,255,231,.4);padding:12px;
      font-size:.75rem;font-family:'Share Tech Mono',monospace;
      letter-spacing:3px;text-transform:uppercase;cursor:pointer;
      transition:background .2s,box-shadow .2s,border-color .2s;backdrop-filter:blur(4px);
    }
    .btn-connect:hover{background:rgba(0,40,55,.88);box-shadow:0 0 12px rgba(0,255,231,.25);border-color:var(--accent)}
    #msg{margin-top:12px;text-align:center;font-size:.72rem;font-family:'Share Tech Mono',monospace;min-height:18px;letter-spacing:1px}
    .ok{color:var(--accent)}.err{color:var(--danger)}
    .spinner{display:inline-block;width:12px;height:12px;border:2px solid rgba(0,255,231,.15);
             border-top-color:var(--accent);border-radius:50%;animation:spin .7s linear infinite;vertical-align:middle;margin-right:6px}
    @keyframes spin{to{transform:rotate(360deg)}}
  </style>
</head>
<body>
<div class="logo-wrap">
  <div class="logo"><span class="logo-real">32 SERVO</span><span class="logo-driver"> CONTROLLER</span></div>
  <div class="logo-subtitle">&#9658;&nbsp;&nbsp;WIFI SETUP&nbsp;&nbsp;&#9668;</div>
</div>

<div class="login-box">
  <div class="corner-tl"></div><div class="corner-tr"></div>
  <div class="corner-bl"></div><div class="corner-br"></div>

  <div class="field-wrap">
    <div class="field-label"><span style="color:var(--accent2)">//</span><span style="color:var(--accent)"> NETWORK (SSID)</span></div>
    <div class="scan-row">
      <div class="ssid-dropdown" id="ssid-dropdown">
        <div class="ssid-trigger" id="ssid-trigger" onclick="toggleSsidDropdown()">
          <span id="ssid-label">tap Scan to find networks</span>
          <span class="ssid-arrow">&#9660;</span>
        </div>
        <ul class="ssid-menu" id="ssid-menu">
          <li class="ssid-placeholder">tap Scan to find networks</li>
        </ul>
      </div>
      <button type="button" class="btn-scan" onclick="scanNetworks()">SCAN</button>
    </div>
  </div>

  <div class="field-wrap">
    <div class="field-label"><span style="color:var(--accent2)">//</span><span style="color:var(--accent)"> OR TYPE SSID</span></div>
    <input type="text" id="ssid" placeholder="MyWiFiNetwork" autocomplete="off" spellcheck="false">
  </div>

  <div class="field-wrap">
    <div class="field-label"><span style="color:var(--accent2)">//</span><span style="color:var(--accent)"> PASSWORD</span></div>
    <div class="pw-wrap">
      <input type="password" id="pass" placeholder="WiFi password" autocomplete="new-password">
      <span class="eye" onclick="togglePw()">&#128065;</span>
    </div>
  </div>

  <button type="button" class="btn-connect" onclick="doConnect()">[ CONNECT &amp; SAVE ]</button>
  <div id="msg"></div>

  <div style="text-align:center;margin-top:16px">
    <a href="/" style="font-family:'Share Tech Mono',monospace;font-size:9px;letter-spacing:3px;color:rgba(0,255,231,0.35);text-decoration:none;text-transform:uppercase">&#9664; BACK TO CONTROL</a>
  </div>
</div>
<script>
  function msg(text,cls){const e=document.getElementById('msg');e.innerHTML=text;e.className=cls||'';}
  function togglePw(){const p=document.getElementById('pass');p.type=p.type==='password'?'text':'password';}
  function pickSsid(v,label){
    if(v){
      document.getElementById('ssid').value=v;
      document.getElementById('ssid-label').textContent=label||v;
    }
    closeSsidDropdown();
  }
  function toggleSsidDropdown(){
    document.getElementById('ssid-dropdown').classList.toggle('open');
  }
  function closeSsidDropdown(){
    document.getElementById('ssid-dropdown').classList.remove('open');
  }
  document.addEventListener('click',function(e){
    const dd=document.getElementById('ssid-dropdown');
    if(!dd.contains(e.target))closeSsidDropdown();
  });
  function scanNetworks(){
    msg('<span class="spinner"></span>Scanning&hellip;');
    fetch('/scan').then(r=>r.json()).then(nets=>{
      const menu=document.getElementById('ssid-menu');
      menu.innerHTML='';
      if(nets.length===0){
        const li=document.createElement('li');
        li.className='ssid-placeholder';
        li.textContent='No networks found';
        menu.appendChild(li);
      } else {
        nets.forEach(n=>{
          const li=document.createElement('li');
          const label=n.ssid;
          const rssi=n.rssi+' dBm';
          li.innerHTML=label+'<span>'+rssi+'</span>';
          li.onclick=()=>pickSsid(n.ssid,n.ssid);
          menu.appendChild(li);
        });
      }
      document.getElementById('ssid-label').textContent='select a network';
      msg(nets.length+' networks found','ok');
    }).catch(()=>msg('Scan failed - try again','err'));
  }
  function doConnect(){
    const ssid=document.getElementById('ssid').value.trim();
    const pass=document.getElementById('pass').value;
    if(!ssid){msg('Please enter a network name (SSID)','err');return;}
    msg('<span class="spinner"></span>Saving &amp; connecting&hellip;');
    fetch('/save',{method:'POST',
      headers:{'Content-Type':'application/x-www-form-urlencoded'},
      body:'ssid='+encodeURIComponent(ssid)+'&pass='+encodeURIComponent(pass)
    }).then(r=>r.text()).then(t=>msg(t,'ok')).catch(()=>msg('Close this page and reconnect to WiFi','err'));
  }
  function setAPMode(){
    if(!confirm('Switch to Access Point mode? The device will reboot and broadcast its own WiFi network.'))return;
    msg('<span class="spinner"></span>Switching to AP mode&hellip;');
    fetch('/setap').then(r=>r.text()).then(t=>{
      msg(t,'ok');
    }).catch(()=>msg('Done — reconnect to 32_SC_Setup network','ok'));
  }
  window.addEventListener('DOMContentLoaded',scanNetworks);
  (function(){var l=document.createElement('link');l.rel='stylesheet';
  l.href='https://fonts.googleapis.com/css2?family=Orbitron:wght@400;600;800&family=Share+Tech+Mono&display=swap';
  document.head.appendChild(l);})();
</script>
</body>
</html>

)rawliteral";

// -------------------------------------------------------------
//  HTML - main page: camera + servo sliders (STA mode)
// -------------------------------------------------------------
static const char MAIN_HTML[] PROGMEM = R"rawliteral(
<!DOCTYPE html>
<html lang="en">
<head>
  <meta charset="UTF-8">
  <meta name="viewport" content="width=device-width, initial-scale=1">
<link rel="icon" type="image/x-icon" href="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">
  <title>32 Servo Controller</title>
  <link rel="preconnect" href="https://fonts.googleapis.com">
  <link href="https://fonts.googleapis.com/css2?family=Orbitron:wght@400;600;800&family=Share+Tech+Mono&display=swap" rel="stylesheet">
  <style>
    *{box-sizing:border-box;margin:0;padding:0}
    :root{
      --bg:#050709;--panel:rgba(8,16,28,0.92);--border:rgba(0,255,231,0.18);
      --accent:#00ffe7;--accent2:#ff3c5f;--green:#00ff88;
      --text:#b8d8e8;--dim:#3a5060;--muted:#4a6878;--danger:#ff3c5f;
    }
    html,body{min-height:100vh;background:var(--bg);color:var(--text);font-family:'Orbitron',monospace}
    body::before{
      content:'';position:fixed;inset:0;
      background-image:linear-gradient(rgba(0,255,231,0.05) 1px,transparent 1px),
        linear-gradient(90deg,rgba(0,255,231,0.05) 1px,transparent 1px);
      background-size:48px 48px;pointer-events:none;z-index:0;
    }
    body::after{
      content:'';position:fixed;inset:0;
      background:repeating-linear-gradient(0deg,transparent,transparent 3px,rgba(0,0,0,0.06) 3px,rgba(0,0,0,0.06) 4px);
      pointer-events:none;z-index:0;
    }
    #header{
      position:relative;z-index:2;
      display:flex;align-items:center;justify-content:space-between;
      padding:14px 24px;min-height:64px;
      border-bottom:1px solid var(--border);
      background:var(--panel);backdrop-filter:blur(10px);
    }
    .logo-wrap{display:flex;flex-direction:column;align-items:center}
    @keyframes statglow-cyan{
      0%,100%{text-shadow:-2px 0 rgba(0,255,231,0.45),2px 0 rgba(255,60,95,0.45),0 0 10px rgba(0,255,231,0.8),0 0 24px rgba(0,255,231,0.4)}
      50%{text-shadow:-4px 0 rgba(0,255,231,0.7),4px 0 rgba(255,60,95,0.7),0 0 22px rgba(0,255,231,1),0 0 44px rgba(0,255,231,0.5)}
    }
    @keyframes statglow-pink{
      0%,100%{text-shadow:-2px 0 rgba(0,255,231,0.45),2px 0 rgba(255,60,95,0.45),0 0 10px rgba(255,60,95,0.8),0 0 24px rgba(255,60,95,0.4)}
      50%{text-shadow:-4px 0 rgba(0,255,231,0.7),4px 0 rgba(255,60,95,0.7),0 0 22px rgba(255,60,95,1),0 0 44px rgba(255,60,95,0.5)}
    }
    @keyframes logo-flicker{0%,90%,92%,97%,97.5%,100%{opacity:1}91.4%{opacity:.12}97.2%{opacity:.55}}
    .logo{font-size:1rem;font-weight:800;letter-spacing:4px;color:var(--accent);text-transform:uppercase;position:relative;animation:statglow-cyan 2.5s ease-in-out infinite,logo-flicker 8s ease-in-out infinite}
    .logo .logo-real{color:var(--accent);animation:statglow-cyan 2.5s ease-in-out infinite,logo-flicker 8s ease-in-out infinite}
    .logo .logo-driver{color:var(--accent2);animation:statglow-pink 2.5s ease-in-out infinite,logo-flicker 8s ease-in-out infinite .3s}
    .logo-subtitle{font-family:'Share Tech Mono',monospace;font-size:9px;letter-spacing:3px;color:var(--accent);margin-top:4px}
    .page{position:relative;z-index:1;padding:16px 16px 40px;max-width:900px;margin:0 auto}
    button{
      background:transparent;border:1px solid var(--border);color:var(--muted);
      padding:8px 18px;cursor:pointer;font-size:.68rem;font-family:'Orbitron',monospace;
      letter-spacing:2px;text-transform:uppercase;border-radius:0;
      transition:border-color .2s,color .2s,box-shadow .2s;
    }
    button:hover{border-color:var(--accent);color:var(--accent);box-shadow:0 0 10px rgba(0,255,231,.2)}
    button.active{background:rgba(0,255,231,.12);color:var(--accent);border-color:var(--accent);box-shadow:0 0 12px rgba(0,255,231,.3)}
    .danger-btn{border-color:rgba(255,60,95,.7);color:var(--danger);border-radius:4px;font-size:10px;font-weight:600;padding:7px 14px;}
    .danger-btn:hover{border-color:var(--danger)!important;color:var(--danger)!important;box-shadow:0 0 14px rgba(255,60,95,.35)!important}
    .input-mode-bar{
      display:flex;align-items:center;justify-content:center;gap:14px;
      margin-bottom:16px;padding-bottom:16px;border-bottom:1px solid var(--border);
    }
    .mode-label{font-size:.65rem;font-weight:700;letter-spacing:.1em;text-transform:uppercase;color:var(--dim);transition:color .2s;user-select:none}
    .mode-label.active{color:var(--accent)}
    .toggle-track{
      position:relative;width:52px;height:26px;border-radius:13px;
      background:rgba(0,0,0,.4);border:1px solid var(--border);cursor:pointer;
      transition:background .25s,border-color .25s;flex-shrink:0;
    }
    .toggle-track.joystick{background:rgba(0,255,231,.1);border-color:var(--accent);box-shadow:0 0 8px rgba(0,255,231,.3)}
    .toggle-thumb{position:absolute;top:3px;left:3px;width:18px;height:18px;border-radius:50%;background:var(--dim);transition:transform .25s,background .25s}
    .toggle-track.joystick .toggle-thumb{transform:translateX(26px);background:var(--accent)}
    .toggle-track.disabled{opacity:.35;cursor:not-allowed}
    .toggle-track.disabled:hover{border-color:var(--border)}
    .mode-label.dimmed{color:#1a2530!important}
    .servo-section{margin-top:12px}
    .sl-slash{color:var(--accent2)}
    details.slider-panel{overflow:hidden}
    details.slider-panel summary{
      display:flex;justify-content:space-between;align-items:center;
      padding:6px 12px;cursor:pointer;list-style:none;
      border:1px solid var(--border);
      background:rgba(5,10,16,0.80);
      font-family:'Share Tech Mono',monospace;font-size:10px;
      color:var(--accent);letter-spacing:2px;
      backdrop-filter:blur(6px);
      user-select:none;transition:background .15s;
    }
    details.slider-panel summary::-webkit-details-marker{display:none}
    details.slider-panel summary:hover{background:rgba(5,10,16,0.95)}
    details.slider-panel[open] summary{border-bottom:none}
    .summary-chevron{font-size:11px;color:var(--accent)}
    .summary-chevron::before{content:'\25B8'}
    details.slider-panel[open] .summary-chevron::before{content:'\25BE'}
    .slider-panel-inner{
      border:1px solid var(--border);border-top:none;
      background:rgba(5,10,16,0.72);padding:12px;
      backdrop-filter:blur(6px);
    }
    .servo-grid{display:grid;grid-template-columns:1fr 1fr;gap:24px}
    @media(max-width:560px){.servo-grid{grid-template-columns:1fr}}
    .servo-col h3{
      font-size:.68rem;font-weight:700;color:var(--accent);
      text-align:center;padding:6px;
      background:rgba(0,255,231,.05);border:1px solid var(--border);
      margin-bottom:12px;letter-spacing:.08em;text-transform:uppercase;
      text-shadow:0 0 8px rgba(0,255,231,.5);
    }
    .servo-item{display:flex;align-items:center;gap:8px;margin-bottom:8px}
    .servo-label{min-width:72px;font-size:.68rem;color:var(--accent);font-family:'Share Tech Mono',monospace;font-weight:600;white-space:nowrap;text-transform:uppercase}
    input[type=range]{flex:1;accent-color:var(--accent);cursor:pointer;height:4px}
    .servo-val{min-width:30px;text-align:right;font-size:.72rem;font-weight:700;color:var(--accent);font-family:'Share Tech Mono',monospace}
    .servo-actions{display:flex;gap:8px;margin-top:16px;flex-wrap:wrap}
    .servo-actions button{flex:1;min-width:110px}
    .cyber-select{position:relative;width:100%}
    .map-cs{min-width:0}
    .cyber-select-btn{
      width:100%;height:36px;box-sizing:border-box;background:rgba(0,20,30,0.75);border:1px solid rgba(0,255,231,0.3);
      color:var(--accent);font-family:'Share Tech Mono',monospace;font-size:.72rem;
      padding:0 8px;cursor:pointer;transition:border-color .2s,background .2s;
      text-align:left;letter-spacing:1px;backdrop-filter:blur(4px);
      display:flex;align-items:center;justify-content:space-between;gap:4px;
    }
    .cyber-select-btn:hover,.cyber-select-btn.open{border-color:rgba(0,255,231,.85);background:rgba(0,30,45,.82)}
    .cs-label{overflow:hidden;text-overflow:ellipsis;white-space:nowrap;flex:1;min-width:0}
    .cs-arrow{opacity:.5;font-size:.65rem;flex-shrink:0}
    .cyber-select-list{
      background:#050a10;border:1px solid rgba(0,255,231,0.3);
      max-height:180px;overflow-y:auto;
      font-family:'Share Tech Mono',monospace;font-size:.72rem;display:none;
    }
    .cyber-select-list::-webkit-scrollbar{width:14px;height:14px}
    .cyber-select-list::-webkit-scrollbar-track{background:#0a0e14;border-left:1px solid #0099bb22}
    .cyber-select-list::-webkit-scrollbar-thumb{background:#0099bb;border-radius:0;box-shadow:0 0 6px #0099bb,0 0 12px #0099bb66}
    .cyber-select-list::-webkit-scrollbar-thumb:hover{background:#00e5ff;box-shadow:0 0 8px #00e5ff,0 0 18px #00e5ffaa}
    .cyber-select-list::-webkit-scrollbar-corner{background:#0a0e14}
    .cs-opt{padding:7px 10px;color:var(--accent);cursor:pointer;letter-spacing:1px;transition:background .1s;white-space:nowrap;overflow:hidden;text-overflow:ellipsis}
    .cs-opt:hover{background:rgba(0,255,231,.1);color:#fff}
    .cs-opt.selected{background:rgba(0,255,231,.15);border-left:2px solid var(--accent)}
    .map-check-label{display:flex;align-items:center;gap:4px;font-family:'Share Tech Mono',monospace;font-size:.72rem;color:var(--accent);white-space:nowrap;cursor:pointer}
    .map-check-label input[type=checkbox]{appearance:none;-webkit-appearance:none;width:11px;height:11px;flex-shrink:0;background:rgba(0,10,18,0.85);border:1px solid rgba(0,255,231,0.35);cursor:pointer;position:relative;transition:border-color .15s,box-shadow .15s}
    .map-check-label input[type=checkbox]:checked{background:rgba(0,255,231,0.15);border-color:var(--accent);box-shadow:0 0 6px rgba(0,255,231,0.5)}
    .map-check-label input[type=checkbox]:checked::after{content:'';position:absolute;left:2px;top:0px;width:4px;height:7px;border:1.5px solid var(--accent);border-top:none;border-left:none;transform:rotate(45deg)}
    .map-dz-label{display:flex;align-items:center;gap:4px;font-family:'Share Tech Mono',monospace;font-size:.72rem;color:var(--accent);white-space:nowrap}
    .map-dz-label input{width:62px;height:36px;box-sizing:border-box;background:rgba(0,10,18,0.85);border:1px solid rgba(0,255,231,0.2);color:var(--accent);font-family:'Share Tech Mono',monospace;font-size:.72rem;padding:0 4px;outline:none;text-align:center}
    .map-dz-label input::-webkit-inner-spin-button,.map-dz-label input::-webkit-outer-spin-button{opacity:1;height:100%;filter:invert(1) sepia(1) saturate(3) hue-rotate(155deg)}
    .map-val-input{width:58px;height:36px;box-sizing:border-box;background:rgba(0,10,18,0.85);border:1px solid rgba(0,255,231,0.2);color:var(--accent);font-family:'Share Tech Mono',monospace;font-size:9px;padding:0 4px;outline:none;text-align:center}
    .map-val-input::-webkit-inner-spin-button,.map-val-input::-webkit-outer-spin-button{opacity:1;height:100%;filter:invert(1) sepia(1) saturate(3) hue-rotate(155deg)}
    .map-remove-btn{font-family:'Share Tech Mono',monospace;font-size:10px;padding:0;width:36px;height:36px;background:transparent;border:1px solid rgba(255,60,95,0.3);color:rgba(255,60,95,0.5);cursor:pointer;transition:all .2s;box-sizing:border-box;letter-spacing:0}
    .map-remove-btn:hover{border-color:var(--accent2)!important;color:var(--accent2)!important;box-shadow:none!important}
    /* global scrollbar — cyberpunk neon blue */
    ::-webkit-scrollbar{width:14px;height:14px}
    ::-webkit-scrollbar-track{background:#0a0e14;border-left:1px solid #0099bb22}
    ::-webkit-scrollbar-thumb{background:#0099bb;border-radius:0;box-shadow:0 0 6px #0099bb,0 0 12px #0099bb66}
    ::-webkit-scrollbar-thumb:hover{background:#00e5ff;box-shadow:0 0 8px #00e5ff,0 0 18px #00e5ffaa}
    ::-webkit-scrollbar-corner{background:#0a0e14}
    /* ssid dropdown scrollbar */
    .ssid-menu::-webkit-scrollbar{width:14px;height:14px}
    .ssid-menu::-webkit-scrollbar-track{background:#0a0e14;border-left:1px solid #0099bb22}
    .ssid-menu::-webkit-scrollbar-thumb{background:#0099bb;border-radius:0;box-shadow:0 0 6px #0099bb,0 0 12px #0099bb66}
    .ssid-menu::-webkit-scrollbar-thumb:hover{background:#00e5ff;box-shadow:0 0 8px #00e5ff,0 0 18px #00e5ffaa}
    .ssid-menu::-webkit-scrollbar-corner{background:#0a0e14}
  </style>
</head>
<body>
<div id="header">
  <div class="logo-wrap">
    <div class="logo"><span class="logo-real">32 SERVO</span><span class="logo-driver"> CONTROLLER</span></div>
    <div class="logo-subtitle">&#9658;&nbsp;&nbsp;v1.9&nbsp;&nbsp;&#9668;</div>
  </div>
  <button class="danger-btn" onclick="forgetWifi()">Reset WiFi</button>
</div>

<div class="page">

  <!-- controller status: collapsible panel -->
  <div class="servo-section">
    <details class="slider-panel" id="controller-panel" open>
      <summary>
        <span><span class="sl-slash">//</span> CONTROLLER</span>
        <span class="summary-chevron"></span>
      </summary>
      <div class="slider-panel-inner" style="padding:12px">

        <!-- Status bar -->
        <div style="margin-bottom:14px;padding-bottom:12px;border-bottom:1px solid var(--border)">
          <span id="gp-status" style="color:var(--dim);font-size:.72rem;font-family:'Share Tech Mono',monospace;display:block;text-align:center;width:100%">PRESS A BUTTON TO ACTIVATE CONTROLLER</span>
        </div>

        <!-- -- Axis / Button Mappings -- -->
        <div style="display:flex;align-items:center;justify-content:space-between;margin-bottom:8px">
          <span style="font-size:.66rem;font-weight:700;letter-spacing:.1em;text-transform:uppercase;color:var(--accent)">Axis/Button -> Servo Mapping</span>
          <div style="display:flex;gap:6px">
            <button id="btn-add-axis" onclick="addAxisMapping()" style="padding:4px 10px;font-size:.65rem;border-color:rgba(0,255,231,.4);color:var(--accent)" disabled>+ Add Axis</button>
            <button id="btn-add-button" onclick="addButtonMapping()" style="padding:4px 10px;font-size:.65rem;border-color:rgba(0,255,231,.4);color:var(--accent)" disabled>+ Add Button</button>
          </div>
        </div>
        <div id="no-mappings-msg" style="color:var(--dim);font-size:.72rem;padding:8px 4px;text-align:center;font-family:'Share Tech Mono',monospace">NO MAPPINGS</div>
        <div style="margin-bottom:16px">
          <div id="axis-mappings"></div>
        </div>
        <div>
          <div id="button-mappings"></div>
        </div>

      </div>
    </details>
  </div>

  <!-- servo section: collapsible sliders -->
  <div class="servo-section">
    <details class="slider-panel" id="slider-panel" open>
      <summary>
        <span><span class="sl-slash">//</span> SERVO_CONTROLS</span>
        <span class="summary-chevron"></span>
      </summary>
      <div class="slider-panel-inner">
        <!-- input mode toggle inside panel -->
        <div class="input-mode-bar">
          <span class="mode-label active" id="lbl-slider">Sliders</span>
          <div class="toggle-track" id="mode-toggle" onclick="toggleInputMode()">
            <div class="toggle-thumb"></div>
          </div>
          <span class="mode-label" id="lbl-joystick">Joystick</span>
        </div>
        <div class="servo-grid">
          <div class="servo-col">

            <div id="col-a"></div>
          </div>
          <div class="servo-col">

            <div id="col-b"></div>
          </div>
        </div>
        <div class="servo-actions">

        </div>
      </div>
    </details>
  </div>

</div><!-- /page -->
<script>
  function forgetWifi() {
    if (!confirm('Clear saved WiFi credentials and restart in setup mode?')) return;
    fetch('/forget').then(() => alert('Done! The device will restart into setup mode.'));
  }

  // -- Input mode -------------------------------------------
  let inputMode = 'slider'; // 'slider' or 'joystick'
  let gamepadConnected = false;

  function setToggleEnabled(enabled) {
    const track   = document.getElementById('mode-toggle');
    const lblJoy  = document.getElementById('lbl-joystick');
    const btnAxis = document.getElementById('btn-add-axis');
    const btnBtn  = document.getElementById('btn-add-button');
    // Add buttons unlock as soon as a controller is detected
    const addEnabled = gamepadConnected;
    if (btnAxis) btnAxis.disabled = !addEnabled;
    if (btnBtn)  btnBtn.disabled  = !addEnabled;
    // Toggle only unlocks when controller detected AND at least one mapping exists
    if (enabled) {
      track.classList.remove('disabled');
      lblJoy.classList.remove('dimmed');
    } else {
      track.classList.add('disabled');
      lblJoy.classList.add('dimmed');
    }
  }

  function updateToggleState() {
    const hasMappings = axisMappings.length > 0 || buttonMappings.length > 0;
    setToggleEnabled(gamepadConnected && hasMappings);
  }

  function toggleInputMode() {
    if (!gamepadConnected) return; // block toggle when no controller
    inputMode = (inputMode === 'slider') ? 'joystick' : 'slider';
    const track     = document.getElementById('mode-toggle');
    const lblSlider = document.getElementById('lbl-slider');
    const lblJoy    = document.getElementById('lbl-joystick');
    if (inputMode === 'joystick') {
      track.classList.add('joystick');
      lblSlider.classList.remove('active');
      lblJoy.classList.add('active');
    } else {
      track.classList.remove('joystick');
      lblJoy.classList.remove('active');
      lblSlider.classList.add('active');
    }
  }

  function forceSliderMode() {
    if (inputMode === 'joystick') {
      inputMode = 'slider';
      const track     = document.getElementById('mode-toggle');
      const lblSlider = document.getElementById('lbl-slider');
      const lblJoy    = document.getElementById('lbl-joystick');
      track.classList.remove('joystick');
      lblJoy.classList.remove('active');
      lblSlider.classList.add('active');
    }
  }

  // -- Servos -----------------------------------------------
  const sliders = [];
  const lastSent = new Array(32).fill(0); // match slider default so nothing is sent on page load

  function buildSliders() {
    const colA = document.getElementById('col-a');
    const colB = document.getElementById('col-b');
    for (let i = 0; i < 32; i++) {
      const row = document.createElement('div');
      row.className = 'servo-item';

      const lbl = document.createElement('span');
      lbl.className = 'servo-label';
      lbl.textContent = 'Servo ' + (i + 1) + ':';

      const sl = document.createElement('input');
      sl.type='range'; sl.min=0; sl.max=255; sl.value=0; sl.id='sl'+i;

      const vd = document.createElement('span');
      vd.className='servo-val'; vd.id='v'+i; vd.textContent='0';

      sl.addEventListener('input', function() { vd.textContent = this.value; });

      row.appendChild(lbl); row.appendChild(sl); row.appendChild(vd);
      (i < 16 ? colA : colB).appendChild(row);
      sliders.push(sl);
    }
  }

  function sendServo(num, val) {
    fetch('/servo?num=' + num + '&val=' + val);
  }

  // Poll all sliders every 50ms - only send changed values
  setInterval(function() {
    sliders.forEach(function(sl, i) {
      const val = parseInt(sl.value);
      if (val !== lastSent[i]) {
        lastSent[i] = val;
        sendServo(i, val);
      }
    });
  }, 50);

  function setAll(val) {
    sliders.forEach((sl, i) => {
      sl.value = val;
      document.getElementById('v' + i).textContent = val;
    });
  }
  function centerAll() { setAll(127); }
  function minAll()    { setAll(0);   }
  function maxAll()    { setAll(255); }

  buildSliders();

  // Arrow keys control Servo 1 in slider mode
  document.addEventListener('keydown', function(e) {
    if (inputMode !== 'slider') return;
    if (e.key !== 'ArrowLeft' && e.key !== 'ArrowRight') return;
    e.preventDefault();
    const sl = sliders[0];
    const step = e.shiftKey ? 10 : 1;
    let val = parseInt(sl.value);
    if (e.key === 'ArrowRight') val = Math.min(255, val + step);
    if (e.key === 'ArrowLeft')  val = Math.max(0,   val - step);
    sl.value = val;
    document.getElementById('v0').textContent = val;
  });

  // -- Xbox Controller (Gamepad API) ------------------------
  const gpStatus    = document.getElementById('gp-status');

  // -- Mapping data structures ------------------------------
  // Axis source names: LX LY RX RY LT RT
  // Button indices (standard gamepad layout):
  //   0=A 1=B 2=X 3=Y 4=LB 5=RB 6=LT(btn) 7=RT(btn)
  //   8=Back/Select 9=Start 10=L3 11=R3
  //   12=DUp 13=DDown 14=DLeft 15=DRight

  const AXIS_SOURCES = [
    {id:'LX', label:'Left Stick X',  axisIdx:0, isTrigger:false},
    {id:'LY', label:'Left Stick Y',  axisIdx:1, isTrigger:false},
    {id:'RX', label:'Right Stick X', axisIdx:2, isTrigger:false},
    {id:'RY', label:'Right Stick Y', axisIdx:3, isTrigger:false},
    {id:'LT', label:'Left Trigger',  axisIdx:4, isTrigger:true},
    {id:'RT', label:'Right Trigger', axisIdx:5, isTrigger:true},
  ];

  const BUTTON_SOURCES = [
    {id:'A',     label:'A',          btnIdx:0},
    {id:'B',     label:'B',          btnIdx:1},
    {id:'X',     label:'X',          btnIdx:2},
    {id:'Y',     label:'Y',          btnIdx:3},
    {id:'LB',    label:'LB',         btnIdx:4},
    {id:'RB',    label:'RB',         btnIdx:5},
    {id:'Back',  label:'Back/Select',btnIdx:8},
    {id:'Start', label:'Start',      btnIdx:9},
    {id:'L3',    label:'L3 (L-Click)',btnIdx:10},
    {id:'R3',    label:'R3 (R-Click)',btnIdx:11},
    {id:'DUp',   label:'D-Pad Up',   btnIdx:12},
    {id:'DDown', label:'D-Pad Down', btnIdx:13},
    {id:'DLeft', label:'D-Pad Left', btnIdx:14},
    {id:'DRight','label':'D-Pad Right',btnIdx:15},
  ];

  const BTN_ACTIONS = [
    {id:'set',   label:'Set Value',       hasVal:true,  hold:false, desc:'Instantly set servo to value'},
    {id:'inc',   label:'Increment (hold)',hasVal:true,  hold:true,  desc:'Increase servo while held'},
    {id:'dec',   label:'Decrement (hold)',hasVal:true,  hold:true,  desc:'Decrease servo while held'},
    {id:'toggle',label:'Toggle Min/Max',  hasVal:false, hold:false, desc:'Toggle between 0 and 255'},
  ];

  // Live mapping arrays - each entry is an object
  let axisMappings   = []; // {axisId, servo(0-based), invert, deadzone}
  let buttonMappings = []; // {btnId, servo(0-based), action, value, stepSize}

  // Button toggle state for toggle action
  const btnToggleState = {};
  // Previous button pressed state for edge detection
  const btnPrevState = {};

  let nextAxisId   = 0;
  let nextBtnId    = 0;

  // -- Cyber-select portal system ---------------------------
  const _mapCsCb   = {};
  const _mapCsOpts = {};
  var _mapCsPortal    = null;
  var _mapCsActiveUid = null;

  function _getMapCsPortal() {
    if (!_mapCsPortal) {
      _mapCsPortal = document.createElement('div');
      _mapCsPortal.className = 'cyber-select-list';
      _mapCsPortal.style.cssText = 'position:fixed;z-index:99999;min-width:120px;';
      document.body.appendChild(_mapCsPortal);
    }
    return _mapCsPortal;
  }

  function renderMapCS(uid, opts, selVal, cb) {
    _mapCsCb[uid]   = cb;
    _mapCsOpts[uid] = opts;
    const sel   = opts.find(o => String(o.value) === String(selVal)) || opts[0];
    const label = sel ? sel.label : '-';
    return '<div class="cyber-select map-cs" id="'+uid+'"><div class="cyber-select-btn" onclick="mapCsToggle(\''+uid+'\',event)"><span class="cs-label">'+label+'</span><span class="cs-arrow">&#x25BE;</span></div></div>';
  }

  function _closeAllMapCs() {
    if (_mapCsPortal) _mapCsPortal.style.display = 'none';
    if (_mapCsActiveUid) {
      const w = document.getElementById(_mapCsActiveUid);
      if (w) { const b = w.querySelector('.cyber-select-btn'); if (b) b.classList.remove('open'); }
    }
    _mapCsActiveUid = null;
  }

  function mapCsToggle(uid, e) {
    if (e) e.stopPropagation();
    const wrap = document.getElementById(uid);
    if (!wrap) return;
    const btn    = wrap.querySelector('.cyber-select-btn');
    const isOpen = _mapCsActiveUid === uid;
    _closeAllMapCs();
    if (!isOpen) {
      const opts   = _mapCsOpts[uid] || [];
      const curLbl = btn.querySelector('.cs-label').textContent;
      const portal = _getMapCsPortal();
      portal.innerHTML = opts.map((o,i) =>
        '<div class="cs-opt'+(o.label===curLbl?' selected':'')+'" onclick="mapCsPortalSelect('+i+',event)">'+o.label+'</div>'
      ).join('');
      const rect = btn.getBoundingClientRect();
      portal.style.top     = rect.bottom + 'px';
      portal.style.left    = rect.left   + 'px';
      portal.style.width   = rect.width  + 'px';
      portal.style.display = 'block';
      btn.classList.add('open');
      _mapCsActiveUid = uid;
    }
  }

  function mapCsPortalSelect(idx, e) {
    if (e) e.stopPropagation();
    const uid = _mapCsActiveUid;
    if (!uid) return;
    const opt = (_mapCsOpts[uid] || [])[idx];
    if (!opt) return;
    const wrap = document.getElementById(uid);
    if (wrap) { const lbl = wrap.querySelector('.cs-label'); if (lbl) lbl.textContent = opt.label; }
    _closeAllMapCs();
    if (_mapCsCb[uid]) _mapCsCb[uid](opt.value);
  }

  document.addEventListener('click', _closeAllMapCs);

  // -- Render helpers ---------------------------------------
  function syncNoMappingsMsg() {
    const msg = document.getElementById('no-mappings-msg');
    if (msg) msg.style.display = (axisMappings.length === 0 && buttonMappings.length === 0) ? '' : 'none';
  }

  function renderAxisMappings() {
    const container = document.getElementById('axis-mappings');
    if (axisMappings.length === 0) { container.innerHTML = ''; syncNoMappingsMsg(); return; }
    const servoOpts = Array.from({length:32}, (_,i) => ({value:i, label:'SERVO '+(i+1)}));
    const axisOpts  = AXIS_SOURCES.map(a => ({value:a.id, label:a.label}));
    container.innerHTML = axisMappings.map(m => `
      <div class="mapping-row" id="arow-${m._id}" style="
        display:grid;grid-template-columns:1fr 1fr auto auto auto;
        gap:6px;align-items:center;
        background:rgba(8,16,28,0.8);border:1px solid rgba(0,255,231,0.12);
        padding:8px 10px;margin-bottom:6px">
        ${renderMapCS('acs-ax-'+m._id, axisOpts, m.axisId, v=>updateAxisMapping(m._id,'axisId',v))}
        ${renderMapCS('acs-sv-'+m._id, servoOpts, m.servo, v=>updateAxisMapping(m._id,'servo',parseInt(v)))}
        <label class="map-check-label">
          <input type="checkbox" ${m.invert?'checked':''} onchange="updateAxisMapping(${m._id},'invert',this.checked)"> INV
        </label>
        <label class="map-dz-label">
          DZ<input type="number" value="${m.deadzone}" min="0" max="0.5" step="0.01"
            onchange="updateAxisMapping(${m._id},'deadzone',parseFloat(this.value))">
        </label>
        <button class="map-remove-btn" onclick="removeAxisMapping(${m._id})">&#x2715;</button>
      </div>`).join('');
    syncNoMappingsMsg();
  }

  function renderButtonMappings() {
    const container = document.getElementById('button-mappings');
    if (buttonMappings.length === 0) {
      container.innerHTML = '';
      syncNoMappingsMsg();
      return;
    }
    const servoOpts = Array.from({length:32}, (_,i) => ({value:i, label:'SERVO '+(i+1)}));
    const btnOpts   = BUTTON_SOURCES.map(b => ({value:b.id, label:b.label}));
    const actOpts   = BTN_ACTIONS.map(a => ({value:a.id, label:a.label}));
    container.innerHTML = buttonMappings.map(m => {
      const actionDef = BTN_ACTIONS.find(a => a.id === m.action) || BTN_ACTIONS[0];
      const showVal   = actionDef.hasVal;
      return `
      <div class="mapping-row" id="brow-${m._id}" style="
        display:grid;grid-template-columns:1fr 1fr 1fr ${showVal?'80px':''} auto;
        gap:6px;align-items:center;
        background:rgba(8,16,28,0.8);border:1px solid rgba(0,255,231,0.12);
        padding:8px 10px;margin-bottom:6px">
        ${renderMapCS('bcs-bt-'+m._id, btnOpts, m.btnId, v=>updateButtonMapping(m._id,'btnId',v))}
        ${renderMapCS('bcs-sv-'+m._id, servoOpts, m.servo, v=>updateButtonMapping(m._id,'servo',parseInt(v)))}
        ${renderMapCS('bcs-ac-'+m._id, actOpts, m.action, v=>{updateButtonMapping(m._id,'action',v);renderButtonMappings();})}
        ${showVal ? `<input class="map-val-input" type="number" value="${m.value}" min="0" max="255" step="1"
          onchange="updateButtonMapping(${m._id},'value',parseInt(this.value))"
          title="${actionDef.id==='inc'||actionDef.id==='dec'?'Step size per tick':'Target value (0-255)'}">` : ''}
        <button class="map-remove-btn" onclick="removeButtonMapping(${m._id})">&#x2715;</button>
      </div>`;
    }).join('');
    syncNoMappingsMsg();
  }

  // -- CRUD operations --------------------------------------
  function addAxisMapping() {
    axisMappings.push({_id:nextAxisId++, axisId:'LX', servo:0, invert:false, deadzone:0.08});
    renderAxisMappings();
    updateToggleState();
  }
  function removeAxisMapping(id) {
    axisMappings = axisMappings.filter(m => m._id !== id);
    renderAxisMappings();
    updateToggleState();
  }
  function updateAxisMapping(id, key, val) {
    const m = axisMappings.find(m => m._id === id);
    if (m) m[key] = val;
  }

  function addButtonMapping() {
    buttonMappings.push({_id:nextBtnId++, btnId:'A', servo:0, action:'set', value:255});
    renderButtonMappings();
    updateToggleState();
  }
  function removeButtonMapping(id) {
    buttonMappings = buttonMappings.filter(m => m._id !== id);
    renderButtonMappings();
    updateToggleState();
  }
  function updateButtonMapping(id, key, val) {
    const m = buttonMappings.find(m => m._id === id);
    if (m) m[key] = val;
  }

  // -- Gamepad utility --------------------------------------
  function getXboxGamepad() {
    const pads = navigator.getGamepads ? navigator.getGamepads() : [];
    for (let i = 0; i < pads.length; i++) {
      if (pads[i] && pads[i].id.toLowerCase().includes('xbox')) return pads[i];
    }
    for (let i = 0; i < pads.length; i++) { if (pads[i]) return pads[i]; }
    return null;
  }

  function getAxisValue(gp, axisId) {
    const src = AXIS_SOURCES.find(a => a.id === axisId);
    if (!src) return 0;
    if (src.isTrigger) {
      // Triggers come as buttons (value 0-1) on standard mapping
      const btnIdx = (axisId === 'LT') ? 6 : 7;
      return gp.buttons[btnIdx] ? gp.buttons[btnIdx].value : 0;
      // Normalise 0-1 -> 0-255 (not -1..1)
    }
    return gp.axes[src.axisIdx] || 0;
  }

  function axisToServo255(rawVal, isTrigger, invert, deadzone) {
    let v = rawVal;
    if (!isTrigger) {
      if (Math.abs(v) < deadzone) v = 0;
      v = (v + 1) / 2; // âˆ’1..1 -> 0..1
    } else {
      if (v < deadzone) v = 0;
    }
    if (invert) v = 1 - v;
    return Math.round(v * 255);
  }

  function setSlider(idx, val) {
    val = Math.max(0, Math.min(255, val));
    sliders[idx].value = val;
    document.getElementById('v' + idx).textContent = val;
  }

  window.addEventListener('gamepadconnected', function(e) {
    gamepadConnected = true;
    gpStatus.textContent = e.gamepad.id;
    gpStatus.style.color = 'var(--accent)';
    updateToggleState();
  });
  window.addEventListener('gamepaddisconnected', function(e) {
    gamepadConnected = false;
    gpStatus.textContent = 'No controller detected \u2014 press a button on your Xbox controller to activate';
    gpStatus.style.color = 'var(--dim)';
    updateToggleState();
    forceSliderMode();
  });

  // Initialise toggle as disabled on page load
  setToggleEnabled(false);

  // Render empty mapping lists on load
  renderAxisMappings();
  renderButtonMappings();

  // -- Gamepad polling loop - runs in joystick mode ---------
  setInterval(function() {
    if (inputMode !== 'joystick') return;
    const gp = getXboxGamepad();
    if (!gp) return;

    // -- Process axis mappings --
    axisMappings.forEach(function(m) {
      const src      = AXIS_SOURCES.find(a => a.id === m.axisId);
      const rawVal   = getAxisValue(gp, m.axisId);
      const servoVal = axisToServo255(rawVal, src && src.isTrigger, m.invert, m.deadzone);
      setSlider(m.servo, servoVal);
    });

    // -- Process button mappings --
    buttonMappings.forEach(function(m) {
      const src    = BUTTON_SOURCES.find(b => b.id === m.btnId);
      if (!src) return;
      const btn    = gp.buttons[src.btnIdx];
      const pressed = btn && (btn.pressed || btn.value > 0.5);
      const wasPressed = !!btnPrevState[m._id];
      const risingEdge = pressed && !wasPressed;
      btnPrevState[m._id] = pressed;

      if (!pressed && !risingEdge) return;

      const action = m.action;
      const srv    = m.servo;
      let   cur    = parseInt(sliders[srv].value);

      if (action === 'set'    && risingEdge) { setSlider(srv, m.value); }
      if (action === 'center' && risingEdge) { setSlider(srv, 127); }
      if (action === 'min'    && risingEdge) { setSlider(srv, 0); }
      if (action === 'max'    && risingEdge) { setSlider(srv, 255); }
      if (action === 'toggle' && risingEdge) {
        const key = 'toggle_' + m._id;
        btnToggleState[key] = !btnToggleState[key];
        setSlider(srv, btnToggleState[key] ? 255 : 0);
      }
      if (action === 'inc' && pressed) { setSlider(srv, cur + (m.value || 3)); }
      if (action === 'dec' && pressed) { setSlider(srv, cur - (m.value || 3)); }
    });

  }, 50);
</script>
</body>
</html>
)rawliteral";
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
void loop() {
  if (!usbMode) {
    // WiFi tasks are self-contained; nothing for loop() to do
    vTaskDelay(portMAX_DELAY);
    return;
  }

  // ── USB HID servo update ──
  if (bufferReady) {
    // taskENTER_CRITICAL works on both cores; noInterrupts() only masks Core 1
    taskENTER_CRITICAL(&bufferMux);
    uint8_t rb = writeBuffer;
    writeBuffer = readBuffer;
    readBuffer = rb;
    bufferReady = false;
    taskEXIT_CRITICAL(&bufferMux);

    uint8_t* data = (uint8_t*)servoBuffer[readBuffer];

    for (int x = 0; x < 16; x++) {
      uint32_t us = USMIN + (uint32_t)(data[x] * 7.25);
      pwmA.writeMicroseconds(x, us);
    }
    for (int y = 0; y < 16; y++) {
      uint32_t us = USMIN + (uint32_t)(data[y + 16] * 7.25);
      pwmB.writeMicroseconds(y, us);
    }

    controller.updateLastReport(data);
    lastPrint = millis();

  } else {
    if (millis() - lastPrint > 2000) {
      lastPrint = millis();
      if ((bool)FPSerial) {
        FPSerial.print("Sending keepalive... ");
        FPSerial.print(millis() / 1000);
        FPSerial.println(" seconds since boot");
      }
      controller.sendKeepalive();
    }
  }

  // ── Fingerprint evaluation ───────────────────────────────────
  // Wait 2 seconds after the first HID class request arrives before
  // scoring.  All enumeration traffic (SET_IDLE, SET_PROTOCOL, etc.)
  // finishes well within that window on every OS we care about.
  if (!fp_evaluated && fp_firstHIDReqMs > 0
      && millis() - fp_firstHIDReqMs > 2000) {
    fp_evaluated = true;
    detectedHostType = scoreHostType();  // pure computation — no FPSerial writes

    // Show result on OLED (always, regardless of host type)
    display.clearDisplay();
    display.setTextColor(SSD1306_WHITE);
    display.setTextSize(1);
    display.setCursor(0, 0);
    display.print(F("HOST DETECTED:"));
    display.setTextSize(2);
    display.setCursor(0, 12);
    display.print(hostTypeName(detectedHostType));
    display.display();
  }

  // ── Reprint report when Serial Monitor is opened ─────────────
  // Only relevant for Windows — on Android there is no terminal app
  // and writing to CDC when nobody is reading can block loop() and
  // trigger the Core-1 WDT.  Guard strictly with host-type check.
  static bool fpSerialWasOpen = false;
  bool fpSerialNowOpen = (bool)FPSerial;
  if (fpSerialNowOpen && !fpSerialWasOpen && fp_evaluated) {
    delay(50);  // brief settle so CDC ACKs the open before we flood it
    // Always print the full report when a serial monitor connects — lets you
    // see the actual delta even if the host was mis-classified, so the
    // threshold can be tuned if needed.
    printFingerprintReport(detectedHostType);
    FPSerial.printf("[FP] *** HOST IDENTIFIED: %s ***\n",
                    hostTypeName(detectedHostType));
  }
  fpSerialWasOpen = fpSerialNowOpen;

  // ── Periodic bar-graph update (every 100 ms, after host is identified) ──
  static unsigned long lastBarDraw = 0;
  if (fp_evaluated && millis() - lastBarDraw >= 100) {
    lastBarDraw = millis();
    displayUSBChannels();
  }
}
